PMantix/Switch_Charging_V2/pcb/specs/GDHUIZHT_B0512S_1WR3_product_photo.png

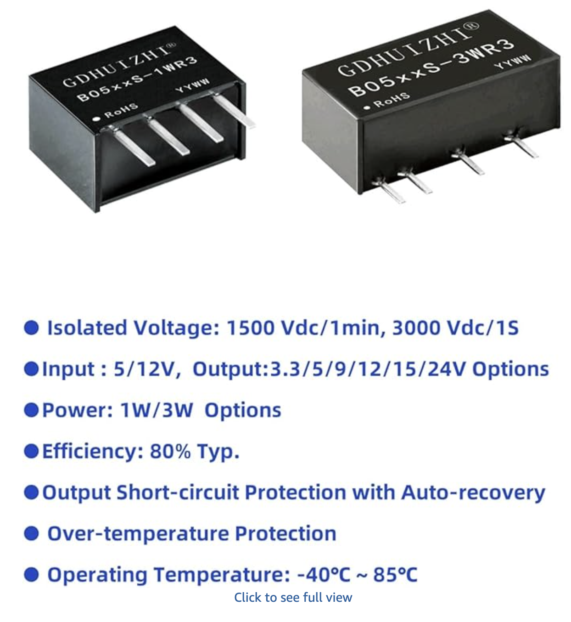
pcb/specs/GDHUIZHT_B0512S_1WR3_product_photo.png
