PMantix/Switch_Charging_V2/docs/Image.png

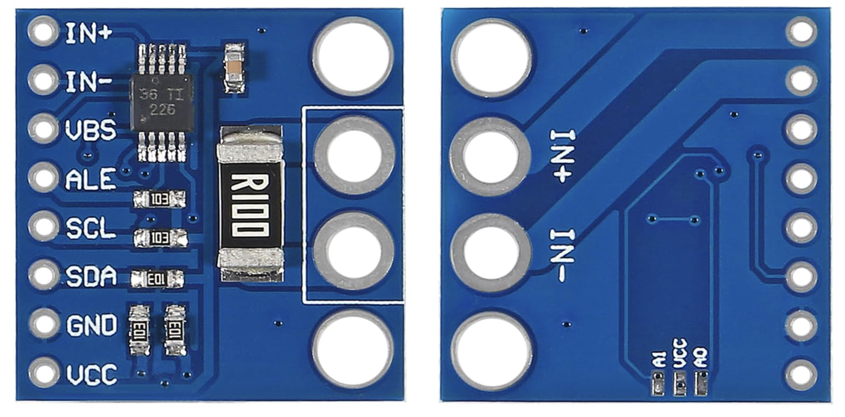
docs/Image.png
