PMantix/Switch_Charging_V2/pcb/specs/GDHUIZHT_B0512S_1WR3_pinout_dimensions.png

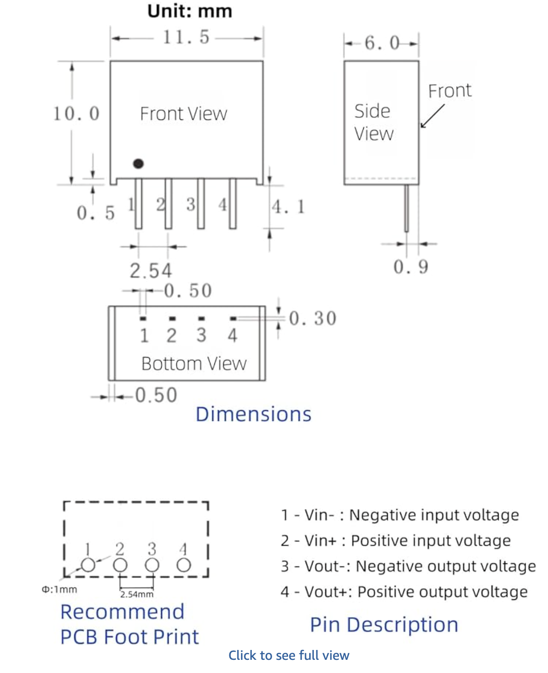
pcb/specs/GDHUIZHT_B0512S_1WR3_pinout_dimensions.png
