PMantix/Switch_Charging_V2/pcb/specs/GDHUIZHT_B0512S_1WR3_specs_general.png

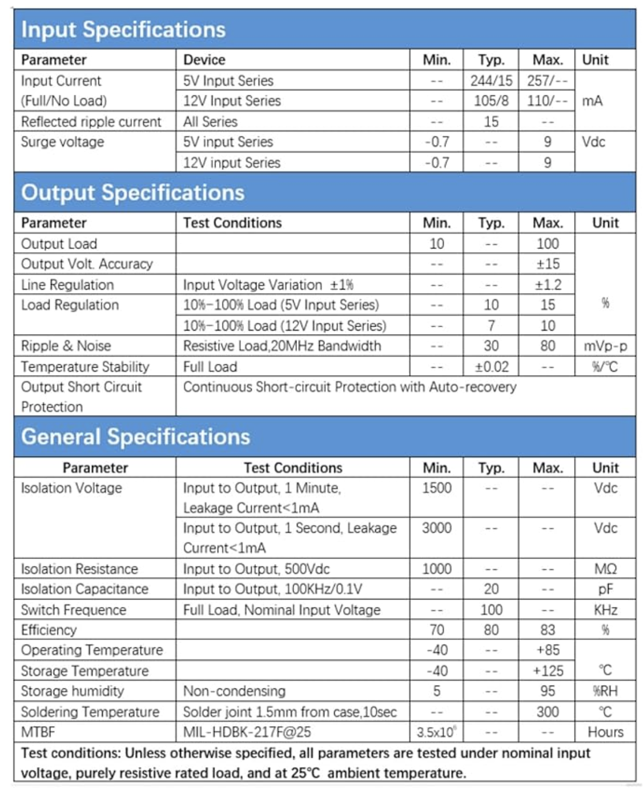
pcb/specs/GDHUIZHT_B0512S_1WR3_specs_general.png
