PMantix/Switch_Charging_V2/pcb/v2/switching_circuit_v2_preview.pdf

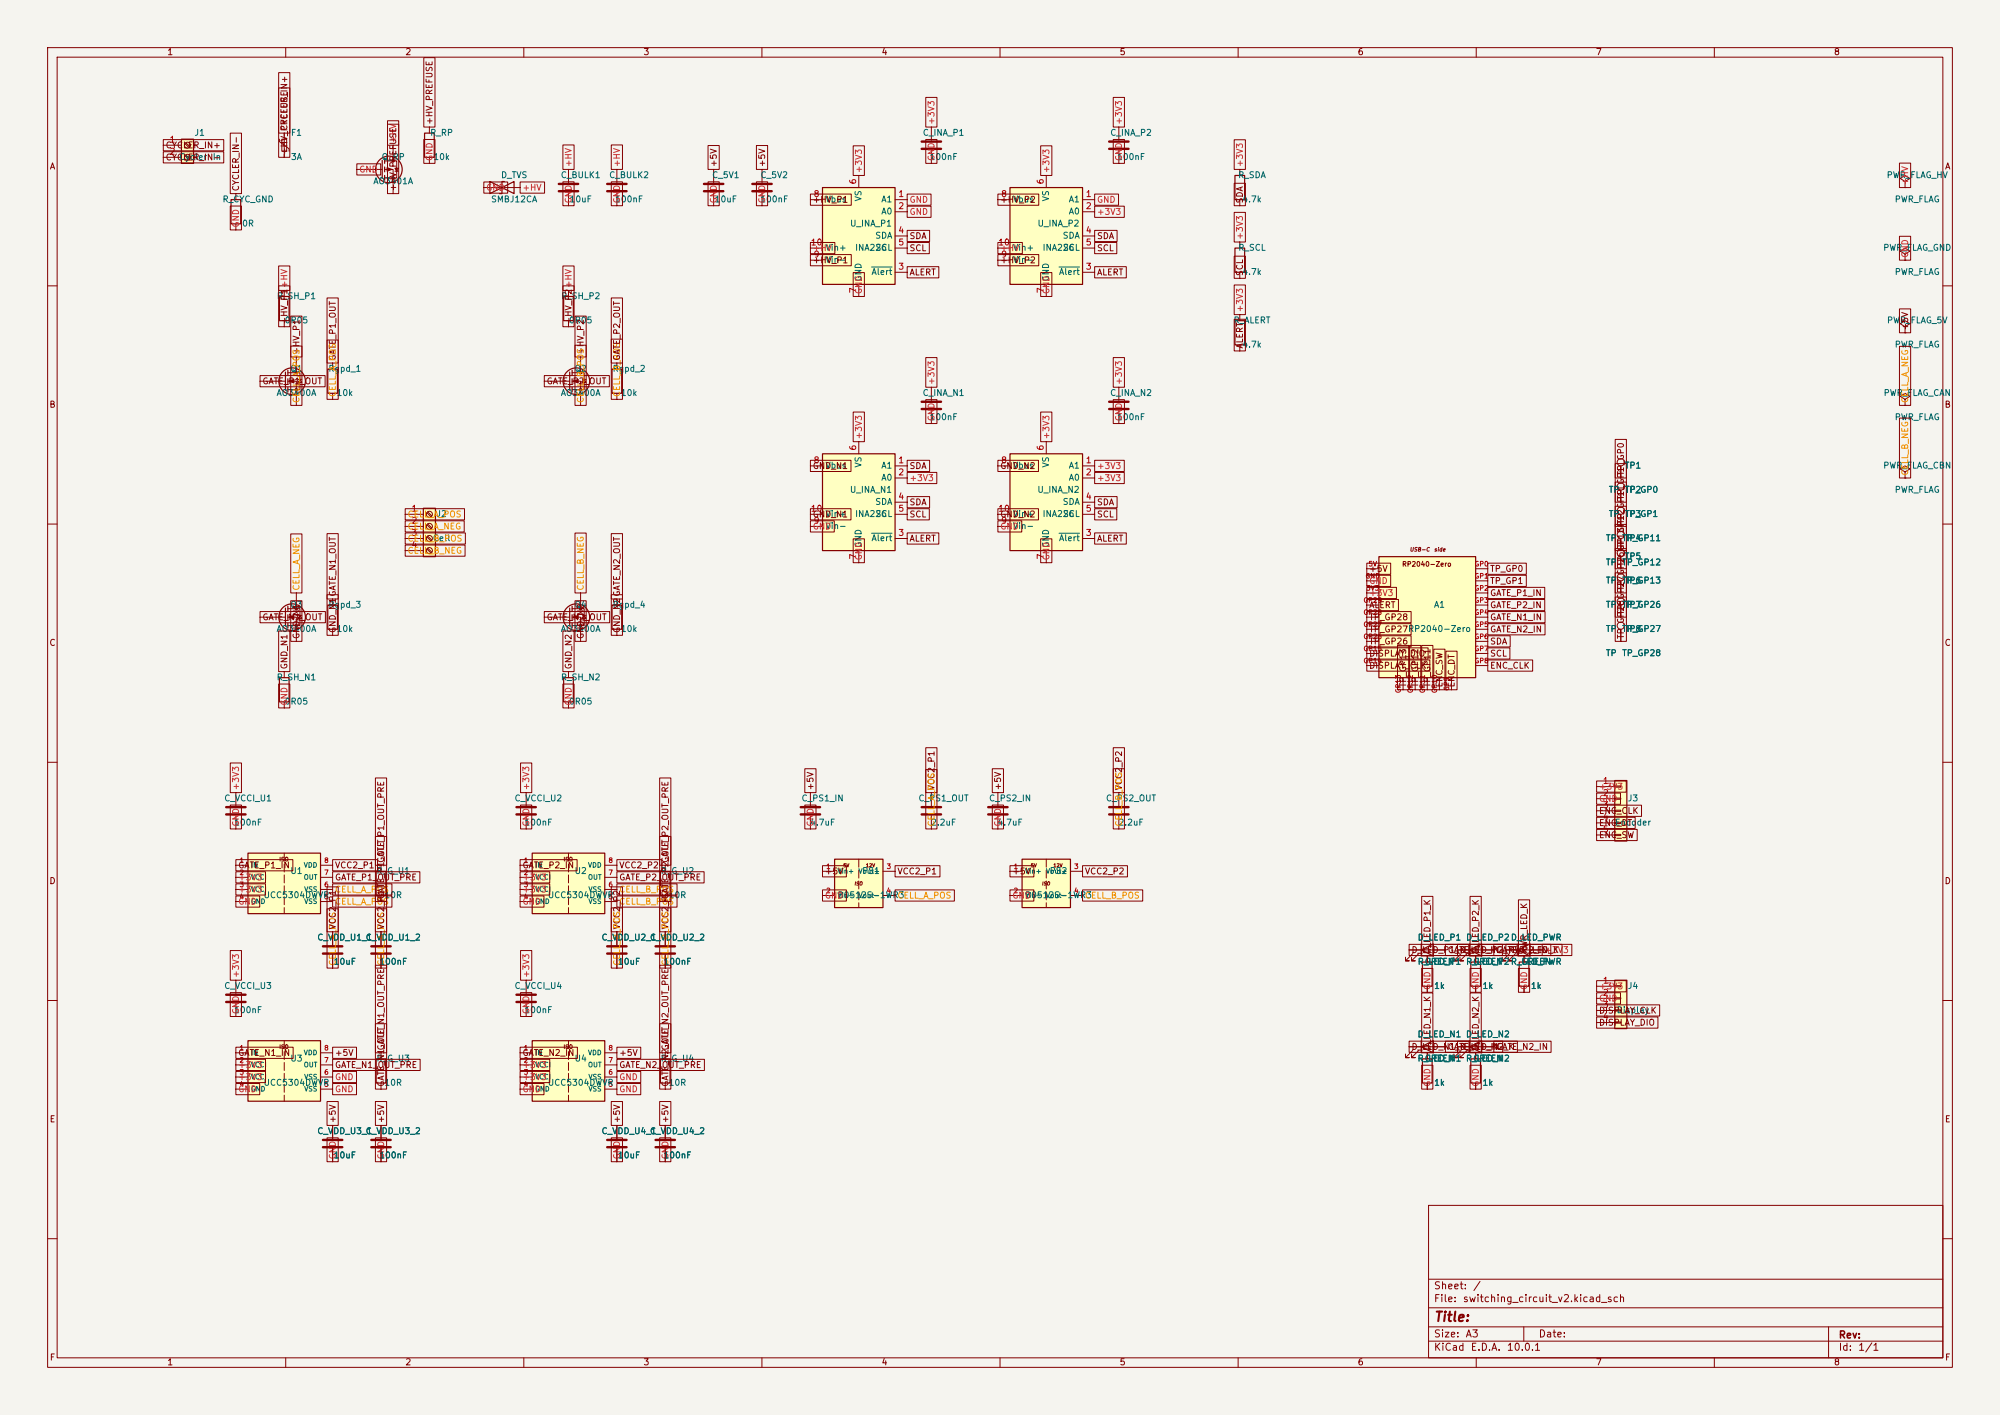
[picture p7: page 1]

Size: A3 | Rev:
KiCad E.D.A. 10.0.1 | Id: 1/1
