PMantix/Switch_Charging_V2/pcb/v3/switching_circuit_v3/switching_circuit_v3.kicad_pcb

## KiCad design pcb/v3/switching_circuit_v3/switching_circuit_v3.kicad_pcb (2026-05-26)

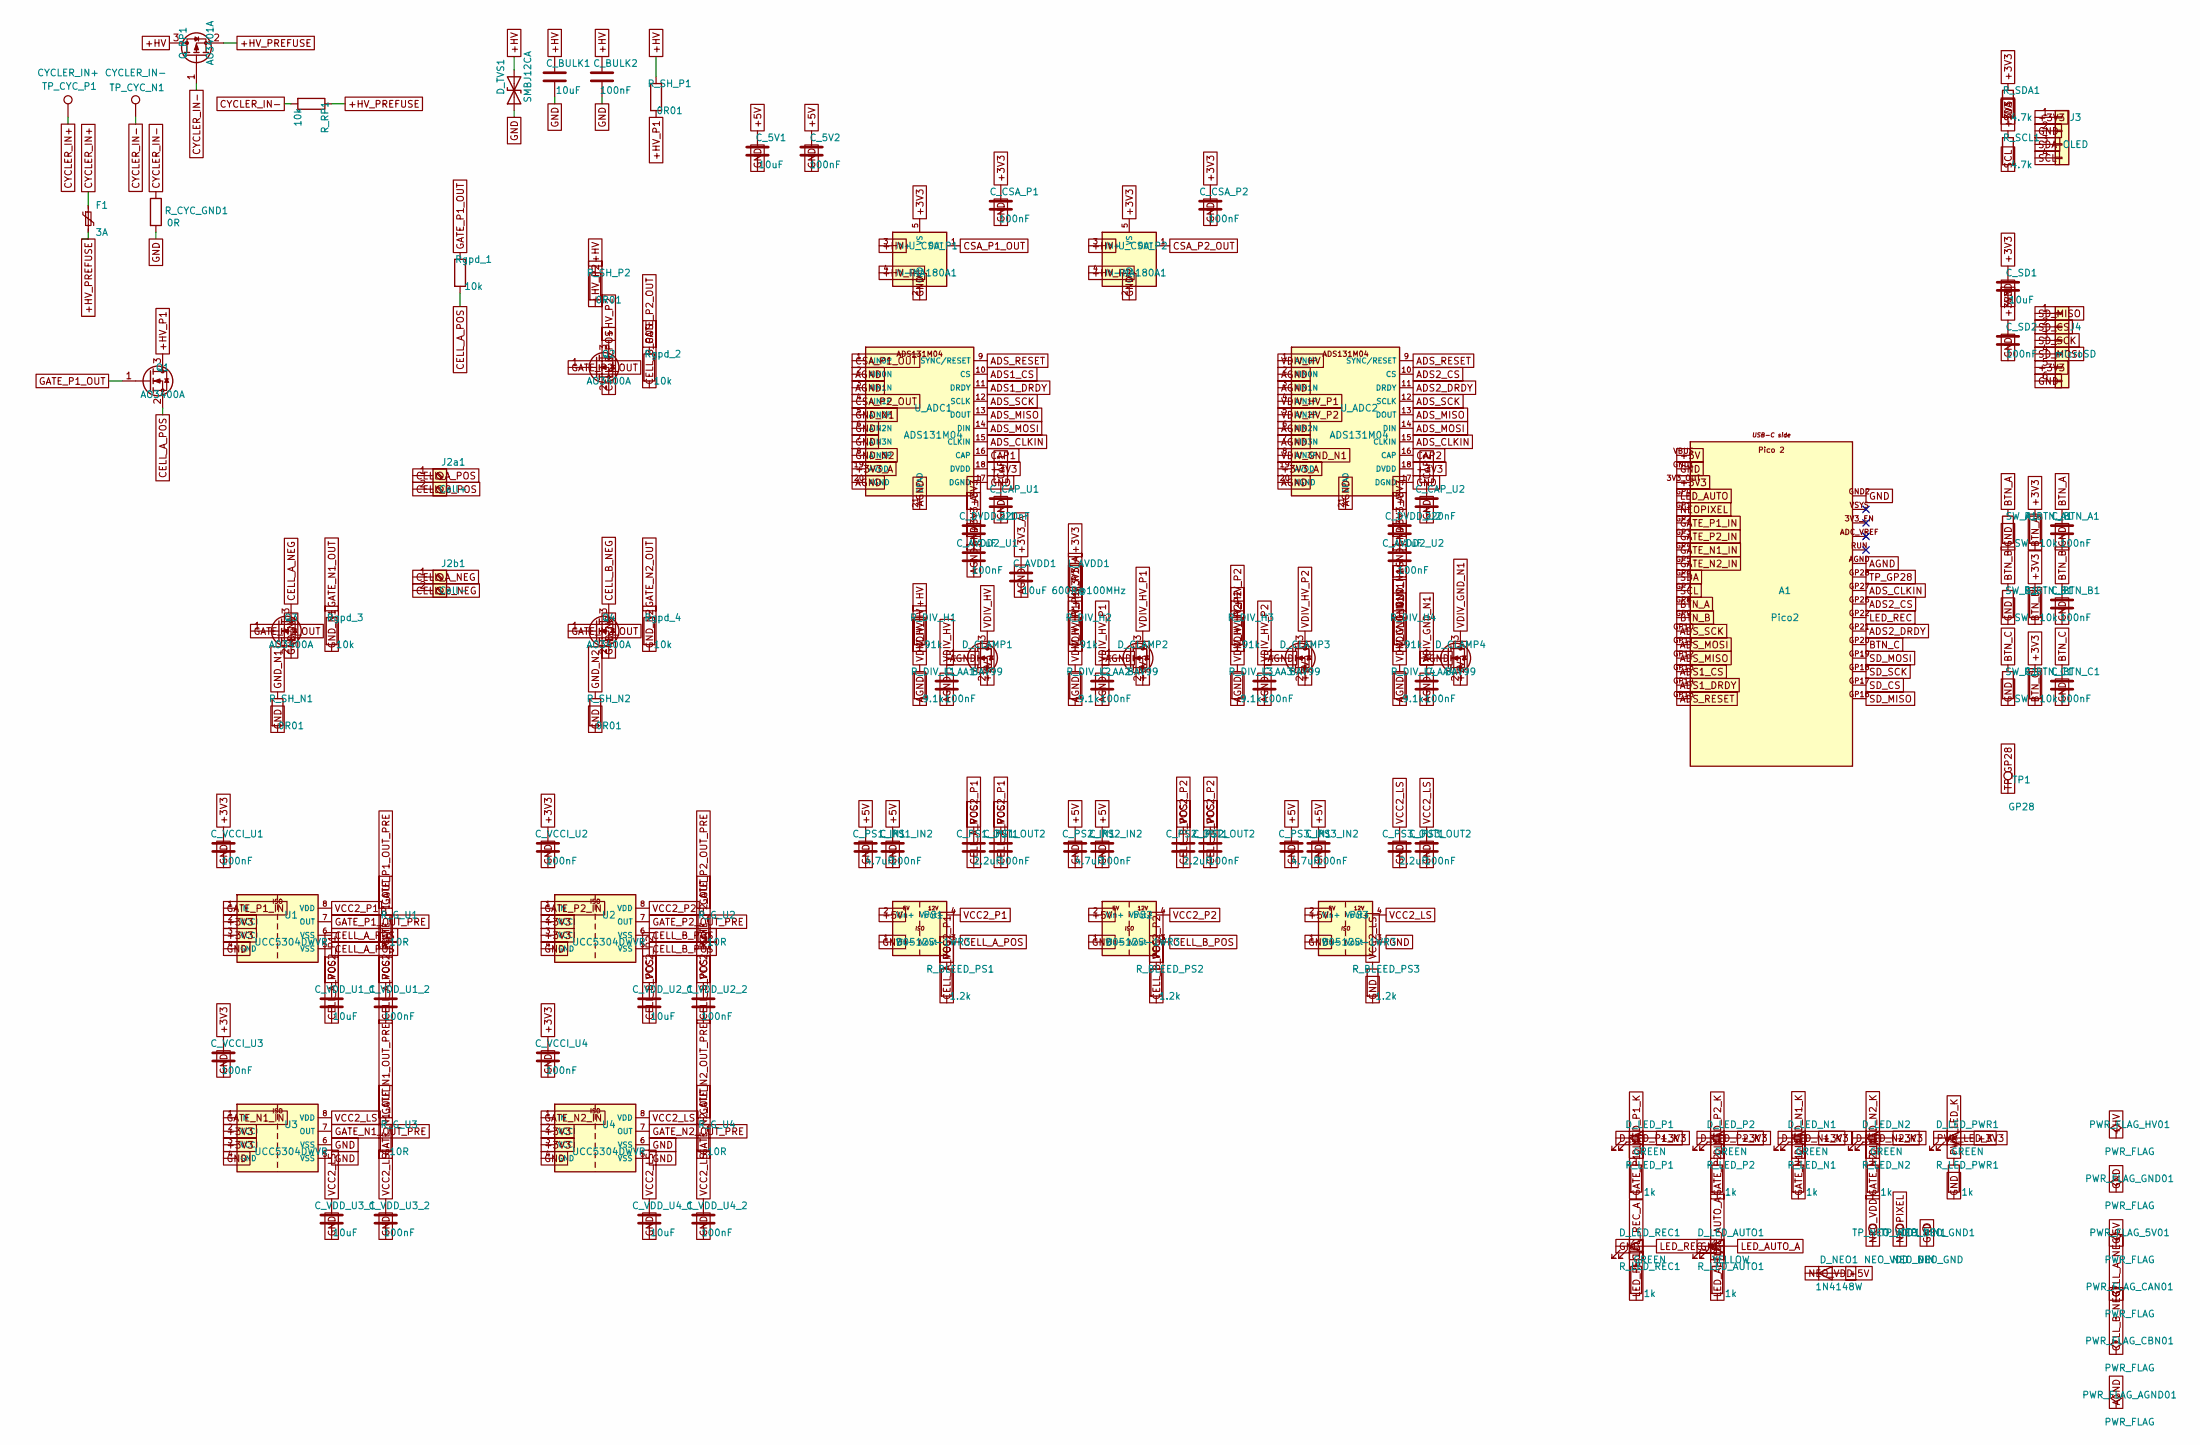
[picture p8: schematic switching_circuit_v3.kicad_sch]

Parts:
A1: Pico2; Pico2_SocketedTH
C_5V1: 10uF; C_0805_2012Metric
C_5V2: 100nF; C_0603_1608Metric
C_AA1, C_AA2, C_AA3, C_AA4: 100nF; C_0603_1608Metric
C_AVDD1: 10uF; C_0805_2012Metric
C_AVDD2_U1, C_AVDD2_U2: 100nF; C_0603_1608Metric
C_BTN_A1: 100nF; C_0603_1608Metric
C_BTN_B1: 100nF; C_0603_1608Metric
C_BTN_C1: 100nF; C_0603_1608Metric
C_BULK1: 10uF; C_1206_3216Metric
C_BULK2: 100nF; C_0603_1608Metric
C_CAP_U1, C_CAP_U2: 220nF; C_0603_1608Metric
C_CSA_P1, C_CSA_P2: 100nF; C_0603_1608Metric
C_DVDD_U1, C_DVDD_U2: 1uF; C_0603_1608Metric
C_PS1_IN1, C_PS2_IN1, C_PS3_IN1: 4.7uF; C_0805_2012Metric
C_PS1_IN2, C_PS1_OUT2, C_PS2_IN2, C_PS2_OUT2, C_PS3_IN2, C_PS3_OUT2: 100nF; C_0603_1608Metric
C_PS1_OUT1, C_PS2_OUT1, C_PS3_OUT1: 2.2uF; C_0805_2012Metric
C_SD1: 10uF; C_0805_2012Metric
C_SD2: 100nF; C_0603_1608Metric
C_VCCI_U1, C_VCCI_U2, C_VCCI_U3, C_VCCI_U4: 100nF; C_0603_1608Metric
C_VDD_U1_1, C_VDD_U2_1, C_VDD_U3_1, C_VDD_U4_1: 10uF; C_1206_3216Metric
C_VDD_U1_2, C_VDD_U2_2, C_VDD_U3_2, C_VDD_U4_2: 100nF; C_0603_1608Metric
D_CLAMP1, D_CLAMP2, D_CLAMP3, D_CLAMP4: BAV99; SOT-23
D_LED_AUTO1: YELLOW; LED_0603_1608Metric
D_LED_N1, D_LED_N2: GREEN; LED_0603_1608Metric
D_LED_P1, D_LED_P2: GREEN; LED_0603_1608Metric
D_LED_PWR1: GREEN; LED_0603_1608Metric
D_LED_REC1: GREEN; LED_0603_1608Metric
D_NEO1: 1N4148W; D_SOD-123
D_TVS1: SMBJ12CA; D_SMB; LCSC C87447
F1: 3A; Fuse_1812_4532Metric
J2a1: Cell+; TerminalBlock_Phoenix_MKDS-1,5-2-5.08_1x02_P5.08mm_Horizont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
J2b1: Cell-; TerminalBlock_Phoenix_MKDS-1,5-2-5.08_1x02_P5.08mm_Horizont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
J3: OLED; JST_XH_B4B-XH-A_1x04_P2.50mm_Vertical
J4: microSD; TF_PUSH
L_AVDD1: 600R@100MHz; R_0603_1608Metric
PS1, PS2, PS3: B0512S-1WR3; B0512S_1WR3_SIP4; MPN B0512S-1WR3
PWR_FLAG_5V01: PWR_FLAG
PWR_FLAG_AGND01: PWR_FLAG
PWR_FLAG_CAN01: PWR_FLAG
PWR_FLAG_CBN01: PWR_FLAG
PWR_FLAG_GND01: PWR_FLAG
PWR_FLAG_HV01: PWR_FLAG
Q1, Q2, Q3, Q4: AO3400A; SOT-23; MPN AO3400A; LCSC C20917
Q_RP1: AO3401A; SOT-23; MPN AO3401A; LCSC C15127
R_BLEED_PS1, R_BLEED_PS2, R_BLEED_PS3: 1.2k; R_0805_2012Metric
R_BTN_A1: 10k; R_0603_1608Metric
R_BTN_B1: 10k; R_0603_1608Metric
R_BTN_C1: 10k; R_0603_1608Metric
R_CYC_GND1: 0R; R_0805_2012Metric
R_DIV_H1, R_DIV_H2, R_DIV_H3, R_DIV_H4: 91k; R_0603_1608Metric
R_DIV_L1, R_DIV_L2, R_DIV_L3, R_DIV_L4: 9.1k; R_0603_1608Metric
R_G_U1, R_G_U2, R_G_U3, R_G_U4: 10R; R_0603_1608Metric
R_LED_AUTO1: 1k; R_0603_1608Metric
R_LED_N1, R_LED_N2: 1k; R_0603_1608Metric
R_LED_P1, R_LED_P2: 1k; R_0603_1608Metric
R_LED_PWR1: 1k; R_0603_1608Metric
R_LED_REC1: 1k; R_0603_1608Metric
R_RP1: 10k; R_0603_1608Metric
R_SCL1: 4.7k; R_0603_1608Metric
R_SDA1: 4.7k; R_0603_1608Metric
R_SH_N1, R_SH_N2: 0R01; R_2512_6332Metric
R_SH_P1, R_SH_P2: 0R01; R_2512_6332Metric
Rgpd_1, Rgpd_2, Rgpd_3, Rgpd_4: 10k; R_0603_1608Metric
SW_A1: SW; SW_SPST_TL3342
SW_B1: SW; SW_SPST_TL3342
SW_C1: SW; SW_SPST_TL3342
TP1: GP28; TestPoint_Pad_D1.5mm
TP_CYC_N1: CYCLER_IN-; TestPoint_Pad_D1.5mm
TP_CYC_P1: CYCLER_IN+; TestPoint_Pad_D1.5mm
TP_NEO_DIN1: NEO_DIN; TestPoint_Pad_D1.5mm
TP_NEO_GND1: NEO_GND; TestPoint_Pad_D1.5mm
TP_NEO_VDD1: NEO_VDD; TestPoint_Pad_D1.5mm
U1, U2, U3, U4: UCC5304DWVR; SOIC-8_DWV_7.5x11.5mm_P1.27mm; MPN UCC5304DWVR
U_ADC1, U_ADC2: ADS131M04; Texas_RUK0020B_WQFN-20-1EP_3x3mm_P0.4mm_EP1.7x1.7mm; LCSC C5121509
U_CSA_P1, U_CSA_P2: INA180A1; SOT-23-5; LCSC C122228

Connections:
+3V3: A1.3V3_OUT, C_CSA_P1.1, C_CSA_P2.1, C_DVDD_U1.1, C_DVDD_U2.1, C_SD1.1, C_SD2.1, C_VCCI_U1.1, C_VCCI_U2.1, C_VCCI_U3.1, C_VCCI_U4.1, D_LED_N1.2 (A), D_LED_N2.2 (A), D_LED_P1.2 (A), D_LED_P2.2 (A), D_LED_PWR1.2 (A), J3.1, J4.5, L_AVDD1.1, R_BTN_A1.1, R_BTN_B1.1, R_BTN_C1.1, R_SCL1.1, R_SDA1.1, U1.2 (VCCI), U1.3 (VCCI), U2.2 (VCCI), U2.3 (VCCI), U3.2 (VCCI), U3.3 (VCCI), U4.2 (VCCI), U4.3 (VCCI), U_ADC1.18 (DVDD), U_ADC2.18 (DVDD), U_CSA_P1.5 (VS), U_CSA_P2.5 (VS)
+3V3_A: C_AVDD1.1, C_AVDD2_U1.1, C_AVDD2_U2.1, D_CLAMP1.2 (S), D_CLAMP2.2 (S), D_CLAMP3.2 (S), D_CLAMP4.2 (S), L_AVDD1.2, U_ADC1.19 (AVDD), U_ADC2.19 (AVDD)
+5V: A1.VBUS, C_5V1.1, C_5V2.1, C_PS1_IN1.1, C_PS1_IN2.1, C_PS2_IN1.1, C_PS2_IN2.1, C_PS3_IN1.1, C_PS3_IN2.1, D_NEO1.2 (A), PS1.2 (Vin+), PS2.2 (Vin+), PS3.2 (Vin+), PWR_FLAG_5V01.1
+HV: C_BULK1.1, C_BULK2.1, D_TVS1.2 (A2), PWR_FLAG_HV01.1, Q_RP1.3 (D), R_DIV_H1.1, R_SH_P1.1, R_SH_P2.1, U_CSA_P1.3 (IN+), U_CSA_P2.3 (IN+)
+HV_P1: Q1.3 (D), R_DIV_H2.1, R_SH_P1.2, U_CSA_P1.4 (IN-)
+HV_P2: Q2.3 (D), R_DIV_H3.1, R_SH_P2.2, U_CSA_P2.4 (IN-)
+HV_PREFUSE: F1.2, Q_RP1.2 (S), R_RP1.1
ADS1_CS: A1.GP13, U_ADC1.10 (CS)
ADS1_DRDY: A1.GP14, U_ADC1.11 (DRDY)
ADS2_CS: A1.GP26, U_ADC2.10 (CS)
ADS2_DRDY: A1.GP21, U_ADC2.11 (DRDY)
ADS_CLKIN: A1.GP27, U_ADC1.15 (CLKIN), U_ADC2.15 (CLKIN)
ADS_MISO: A1.GP12, U_ADC1.13 (DOUT), U_ADC2.13 (DOUT)
ADS_MOSI: A1.GP11, U_ADC1.14 (DIN), U_ADC2.14 (DIN)
ADS_RESET: A1.GP15, U_ADC1.9 (SYNC/RESET), U_ADC2.9 (SYNC/RESET)
ADS_SCK: A1.GP10, U_ADC1.12 (SCLK), U_ADC2.12 (SCLK)
AGND: A1.AGND, C_AA1.2, C_AA2.2, C_AA3.2, C_AA4.2, C_AVDD1.2, C_AVDD2_U1.2, C_AVDD2_U2.2, D_CLAMP1.1 (G), D_CLAMP2.1 (G), D_CLAMP3.1 (G), D_CLAMP4.1 (G), PWR_FLAG_AGND01.1, R_DIV_L1.2, R_DIV_L2.2, R_DIV_L3.2, R_DIV_L4.2, U_ADC1.2 (AIN0N), U_ADC1.3 (AIN1N), U_ADC1.20 (AGND), U_ADC1.21 (EPAD), U_ADC2.2 (AIN0N), U_ADC2.3 (AIN1N), U_ADC2.6 (AIN2N), U_ADC2.7 (AIN3N), U_ADC2.20 (AGND), U_ADC2.21 (EPAD)
BTN_A: A1.GP8, C_BTN_A1.1, R_BTN_A1.2, SW_A1.1
BTN_B: A1.GP9, C_BTN_B1.1, R_BTN_B1.2, SW_B1.1
BTN_C: A1.GP20, C_BTN_C1.1, R_BTN_C1.2, SW_C1.1
CAP1: C_CAP_U1.1, U_ADC1.16 (CAP)
CAP2: C_CAP_U2.1, U_ADC2.16 (CAP)
CELL_A_NEG: J2b1.1, PWR_FLAG_CAN01.1, Q3.3 (D)
CELL_A_POS: C_PS1_OUT1.2, C_PS1_OUT2.2, C_VDD_U1_1.2, C_VDD_U1_2.2, J2a1.1, PS1.3 (Vout-), Q1.2 (S), R_BLEED_PS1.2, Rgpd_1.2, U1.5 (VSS), U1.6 (VSS)
CELL_B_NEG: J2b1.2, PWR_FLAG_CBN01.1, Q4.3 (D)
CELL_B_POS: C_PS2_OUT1.2, C_PS2_OUT2.2, C_VDD_U2_1.2, C_VDD_U2_2.2, J2a1.2, PS2.3 (Vout-), Q2.2 (S), R_BLEED_PS2.2, Rgpd_2.2, U2.5 (VSS), U2.6 (VSS)
CSA_P1_OUT: U_ADC1.1 (AIN0P), U_CSA_P1.1 (OUT)
CSA_P2_OUT: U_ADC1.4 (AIN1P), U_CSA_P2.1 (OUT)
CYCLER_IN+: F1.1, TP_CYC_P1.1 (1_1)
CYCLER_IN-: Q_RP1.1 (G), R_CYC_GND1.1, R_RP1.2, TP_CYC_N1.1 (1_1)
D_LED_N1_K: D_LED_N1.1 (K), R_LED_N1.1
D_LED_N2_K: D_LED_N2.1 (K), R_LED_N2.1
D_LED_P1_K: D_LED_P1.1 (K), R_LED_P1.1
D_LED_P2_K: D_LED_P2.1 (K), R_LED_P2.1
GATE_N1_IN: A1.GP4, R_LED_N1.2, U3.1 (IN)
GATE_N1_OUT: Q3.1 (G), R_G_U3.2, Rgpd_3.1
GATE_N1_OUT_PRE: R_G_U3.1, U3.7 (OUT)
GATE_N2_IN: A1.GP5, R_LED_N2.2, U4.1 (IN)
GATE_N2_OUT: Q4.1 (G), R_G_U4.2, Rgpd_4.1
GATE_N2_OUT_PRE: R_G_U4.1, U4.7 (OUT)
GATE_P1_IN: A1.GP2, R_LED_P1.2, U1.1 (IN)
GATE_P1_OUT: Q1.1 (G), R_G_U1.2, Rgpd_1.1
GATE_P1_OUT_PRE: R_G_U1.1, U1.7 (OUT)
GATE_P2_IN: A1.GP3, R_LED_P2.2, U2.1 (IN)
GATE_P2_OUT: Q2.1 (G), R_G_U2.2, Rgpd_2.1
GATE_P2_OUT_PRE: R_G_U2.1, U2.7 (OUT)
GND: A1.GND1 (GND), A1.GND2 (GND), C_5V1.2, C_5V2.2, C_BTN_A1.2, C_BTN_B1.2, C_BTN_C1.2, C_BULK1.2, C_BULK2.2, C_CAP_U1.2, C_CAP_U2.2, C_CSA_P1.2, C_CSA_P2.2, C_DVDD_U1.2, C_DVDD_U2.2, C_PS1_IN1.2, C_PS1_IN2.2, C_PS2_IN1.2, C_PS2_IN2.2, C_PS3_IN1.2, C_PS3_IN2.2, C_PS3_OUT1.2, C_PS3_OUT2.2, C_SD1.2, C_SD2.2, C_VCCI_U1.2, C_VCCI_U2.2, C_VCCI_U3.2, C_VCCI_U4.2, C_VDD_U3_1.2, C_VDD_U3_2.2, C_VDD_U4_1.2, C_VDD_U4_2.2, D_LED_AUTO1.1 (K), D_LED_REC1.1 (K), D_TVS1.1 (A1), J3.2, J4.6, PS1.1 (Vin-), PS2.1 (Vin-), PS3.1 (Vin-), PS3.3 (Vout-), PWR_FLAG_GND01.1, R_BLEED_PS3.2, R_CYC_GND1.2, R_LED_PWR1.2, R_SH_N1.2, R_SH_N2.2, SW_A1.2, SW_B1.2, SW_C1.2, TP_NEO_GND1.1 (1_1), U1.4 (GND), U2.4 (GND), U3.4 (GND), U3.5 (VSS), U3.6 (VSS), U4.4 (GND), U4.5 (VSS), U4.6 (VSS), U_ADC1.6 (AIN2N), U_ADC1.7 (AIN3N), U_ADC1.17 (DGND), U_ADC2.17 (DGND), U_CSA_P1.2 (GND), U_CSA_P2.2 (GND)
GND_N1: Q3.2 (S), R_DIV_H4.1, R_SH_N1.1, Rgpd_3.2, U_ADC1.5 (AIN2P)
GND_N2: Q4.2 (S), R_SH_N2.1, Rgpd_4.2, U_ADC1.8 (AIN3P)
LED_AUTO: A1.GP0, R_LED_AUTO1.2
LED_AUTO_A: D_LED_AUTO1.2 (A), R_LED_AUTO1.1
LED_REC: A1.GP22, R_LED_REC1.2
LED_REC_A: D_LED_REC1.2 (A), R_LED_REC1.1
NEOPIXEL: A1.GP1, TP_NEO_DIN1.1 (1_1)
NEO_VDD: D_NEO1.1 (K), TP_NEO_VDD1.1 (1_1)
PWR_LED_K: D_LED_PWR1.1 (K), R_LED_PWR1.1
SCL: A1.GP7, J3.4, R_SCL1.2
SDA: A1.GP6, J3.3, R_SDA1.2
SD_CS: A1.GP17, J4.2
SD_MISO: A1.GP16, J4.1
SD_MOSI: A1.GP19, J4.4
SD_SCK: A1.GP18, J4.3
TP_GP28: A1.GP28, TP1.1 (1_1)
VCC2_LS: C_PS3_OUT1.1, C_PS3_OUT2.1, C_VDD_U3_1.1, C_VDD_U3_2.1, C_VDD_U4_1.1, C_VDD_U4_2.1, PS3.4 (Vout+), R_BLEED_PS3.1, U3.8 (VDD), U4.8 (VDD)
VCC2_P1: C_PS1_OUT1.1, C_PS1_OUT2.1, C_VDD_U1_1.1, C_VDD_U1_2.1, PS1.4 (Vout+), R_BLEED_PS1.1, U1.8 (VDD)
VCC2_P2: C_PS2_OUT1.1, C_PS2_OUT2.1, C_VDD_U2_1.1, C_VDD_U2_2.1, PS2.4 (Vout+), R_BLEED_PS2.1, U2.8 (VDD)
VDIV_GND_N1: C_AA4.1, D_CLAMP4.3 (D), R_DIV_H4.2, R_DIV_L4.1, U_ADC2.8 (AIN3P)
VDIV_HV: C_AA1.1, D_CLAMP1.3 (D), R_DIV_H1.2, R_DIV_L1.1, U_ADC2.1 (AIN0P)
VDIV_HV_P1: C_AA2.1, D_CLAMP2.3 (D), R_DIV_H2.2, R_DIV_L2.1, U_ADC2.4 (AIN1P)
VDIV_HV_P2: C_AA3.1, D_CLAMP3.3 (D), R_DIV_H3.2, R_DIV_L3.1, U_ADC2.5 (AIN2P)

Board: 2 copper layers, 128 parts (0 on the bottom side), 70 nets, no tracks yet.
