PMantix/Switch_Charging_V2/pcb/v2/switching_circuit_v2/switching_circuit_v2.kicad_pcb

## KiCad design pcb/v2/switching_circuit_v2/switching_circuit_v2.kicad_pcb (2026-04-21, an earlier design)

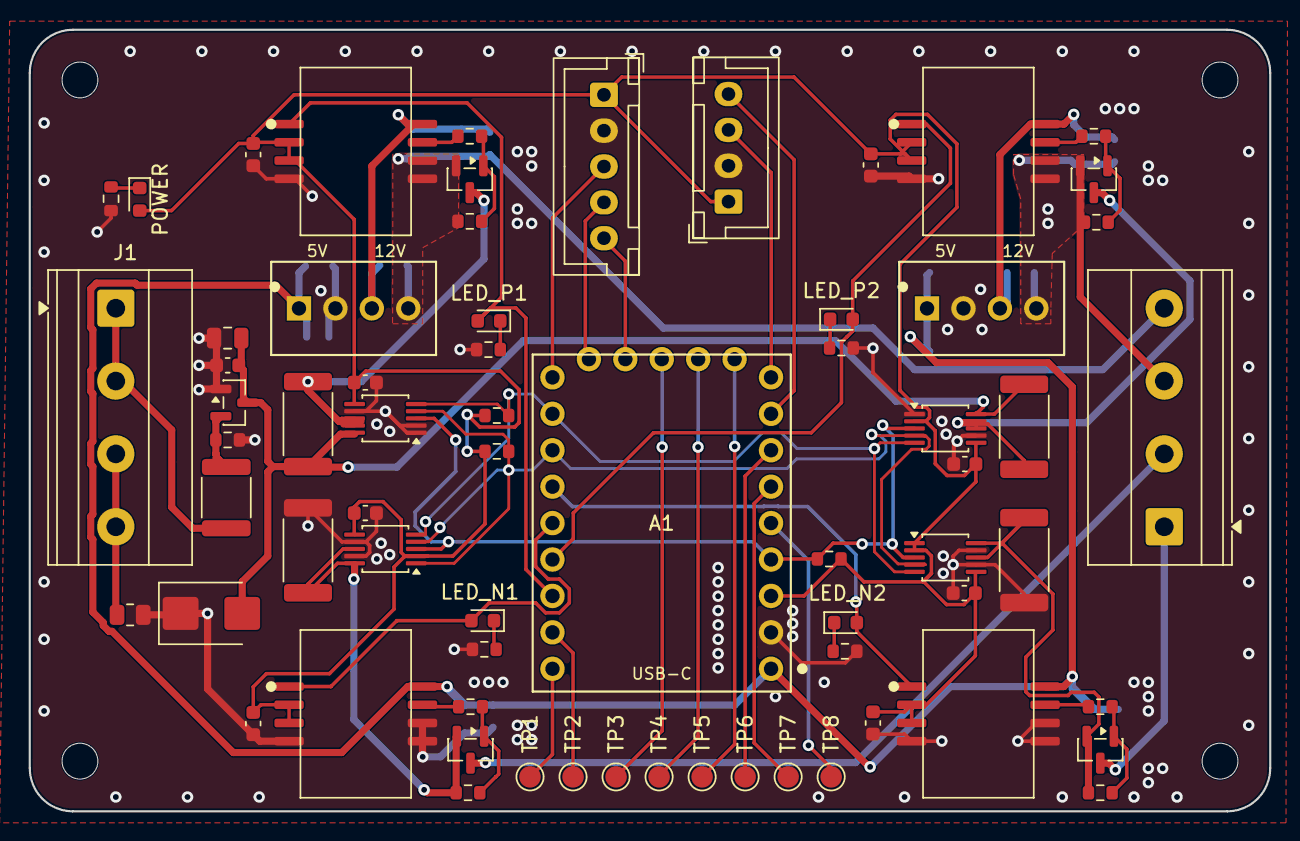
[picture p9: board switching_circuit_v2.kicad_pcb from above]

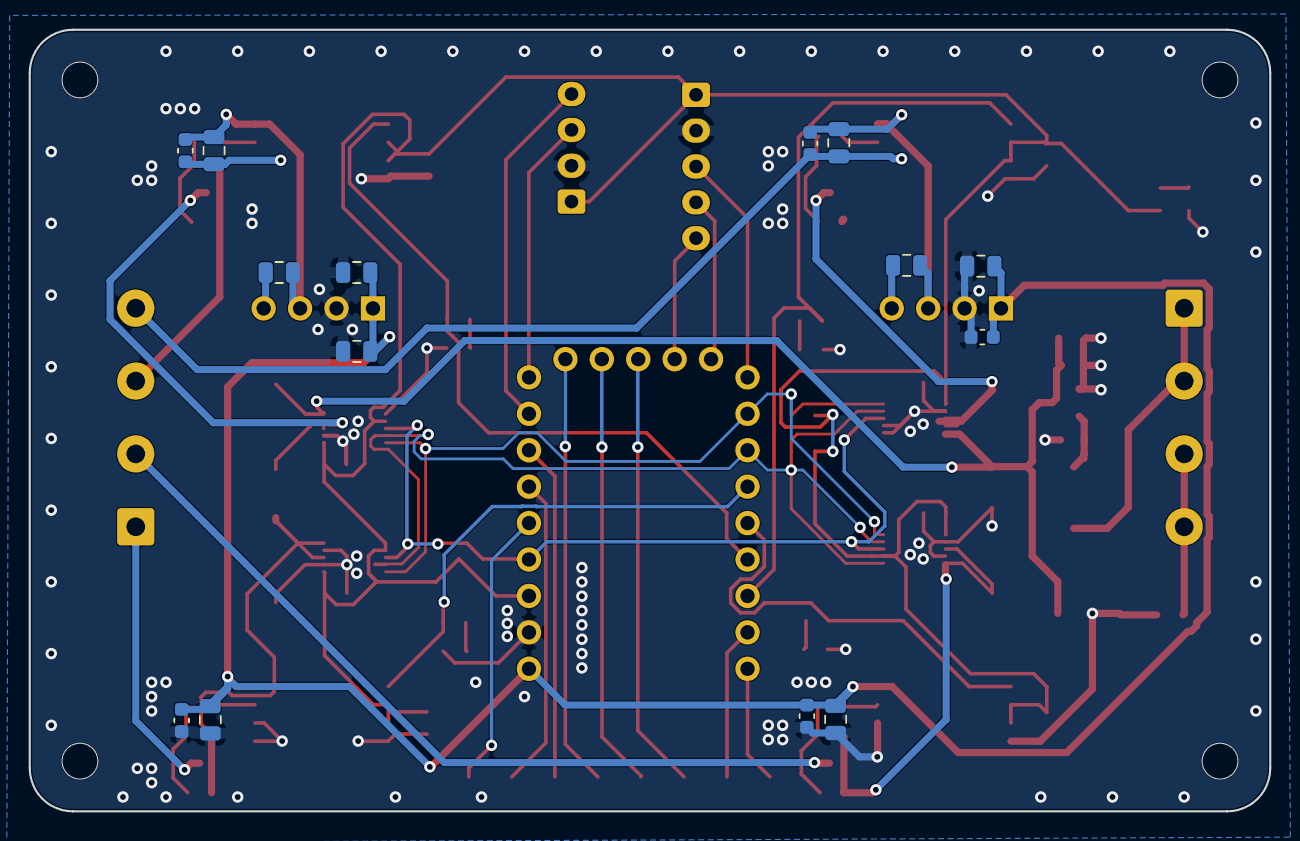
[picture p10: board switching_circuit_v2.kicad_pcb from below]

Board: 2 copper layers, 86.5 x 54.5 mm, 81 parts (14 on the bottom side), 50 nets.

Parts:
A1: RP2040-Zero; RP2040_Zero_SocketedTH
C_5V1: 10uF; C_0805_2012Metric
C_5V2: 100nF; C_0603_1608Metric
C_B1: 10uF; C_0805_2012Metric
C_B2: 100nF; C_0603_1608Metric
C_INA_N1, C_INA_N2: 100nF; C_0603_1608Metric
C_INA_P1, C_INA_P2: 100nF; C_0603_1608Metric
C_PS1_IN1, C_PS2_IN1: 4.7uF; C_0805_2012Metric
C_PS1_OUT1, C_PS2_OUT1: 2.2uF; C_0805_2012Metric
C_VCCI_U1, C_VCCI_U2, C_VCCI_U3, C_VCCI_U4: 100nF; C_0603_1608Metric
C_VDD_U1_1, C_VDD_U2_1, C_VDD_U3_1, C_VDD_U4_1: 10uF; C_0805_2012Metric
C_VDD_U1_2, C_VDD_U2_2, C_VDD_U3_2, C_VDD_U4_2: 100nF; C_0603_1608Metric
D_LED_N1: GREEN; LED_0603_1608Metric
D_TVS1: SMBJ12CA; D_SMB
F1: 3A; Fuse_1812_4532Metric
J1: Cycler In; TerminalBlock_Phoenix_MKDS-1,5-4-5.08_1x04_P5.08mm_Horizont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
J2: Cell; TerminalBlock_Phoenix_MKDS-1,5-4-5.08_1x04_P5.08mm_Horizont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
J3: Encoder; JST_XH_B5B-XH-A_1x05_P2.50mm_Vertical
J4: Display; JST_XH_B4B-XH-A_1x04_P2.50mm_Vertical
LED_N1: 1k; R_0603_1608Metric
LED_N2: GREEN; LED_0603_1608Metric
LED_P1, LED_P2: GREEN; LED_0603_1608Metric
POWER: GREEN; LED_0603_1608Metric
PS1, PS2: B0512S-1WR3; B0512S_1WR3_SIP4
Q1, Q2, Q3, Q4: AO3400A; SOT-23
Q_RP1: AO3401A; SOT-23
R_ALERT1: 4.7k; R_0603_1608Metric
R_CYC_GND1: 0R; R_0805_2012Metric
R_G_U1, R_G_U2, R_G_U3, R_G_U4: 10R; R_0603_1608Metric
R_LED_N2: 1k; R_0603_1608Metric
R_LED_P1, R_LED_P2: 1k; R_0603_1608Metric
R_LED_PWR1: 1k; R_0603_1608Metric
R_RP1: 10k; R_0603_1608Metric
R_SCL1: 4.7k; R_0603_1608Metric
R_SDA1: 4.7k; R_0603_1608Metric
R_SH_N1, R_SH_N2: 0R05; R_2512_6332Metric
R_SH_P1, R_SH_P2: 0R05; R_2512_6332Metric
Rgpd_1, Rgpd_2, Rgpd_3, Rgpd_4: 10k; R_0603_1608Metric
TP1: TP TP_GP0; TestPoint_Pad_D1.5mm
TP2: TP TP_GP1; TestPoint_Pad_D1.5mm
TP3: TP TP_GP11; TestPoint_Pad_D1.5mm
TP4: TP TP_GP12; TestPoint_Pad_D1.5mm
TP5: TP TP_GP13; TestPoint_Pad_D1.5mm
TP6: TP TP_GP26; TestPoint_Pad_D1.5mm
TP7: TP TP_GP27; TestPoint_Pad_D1.5mm
TP8: TP TP_GP28; TestPoint_Pad_D1.5mm
U1, U2, U3, U4: UCC5304DWVR; SOIC-8_DWV_7.5x11.5mm_P1.27mm
U_INA_N1, U_INA_N2: INA226; TSSOP-10_3x3mm_P0.5mm
U_INA_P1, U_INA_P2: INA226; TSSOP-10_3x3mm_P0.5mm

Connections:
+3V3: A1.3V3, C_INA_N1.1, C_INA_N2.1, C_INA_P1.1, C_INA_P2.1, C_VCCI_U1.1, C_VCCI_U2.1, C_VCCI_U3.1, C_VCCI_U4.1, J3.1, J4.1, POWER.2 (A), R_ALERT1.1, R_SCL1.1, R_SDA1.1, U1.2 (VCCI), U1.3 (VCCI), U2.2 (VCCI), U2.3 (VCCI), U3.2 (VCCI), U3.3 (VCCI), U4.2 (VCCI), U4.3 (VCCI), U_INA_N1.2 (A0), U_INA_N1.6 (VS), U_INA_N2.1 (A1), U_INA_N2.2 (A0), U_INA_N2.6 (VS), U_INA_P1.6 (VS), U_INA_P2.2 (A0), U_INA_P2.6 (VS)
+5V: A1.5V, C_5V1.1, C_5V2.1, C_PS1_IN1.1, C_PS2_IN1.1, C_VDD_U3_1.1, C_VDD_U3_2.1, C_VDD_U4_1.1, C_VDD_U4_2.1, PS1.1 (Vin+), PS2.1 (Vin+), U3.8 (VDD), U4.8 (VDD)
+HV: C_B1.1, C_B2.1, D_TVS1.2 (A2), Q_RP1.3 (D), R_SH_P1.1, R_SH_P2.1, U_INA_P1.10 (Vin+), U_INA_P2.10 (Vin+)
+HV_P1: Q1.3 (D), R_SH_P1.2, U_INA_P1.8 (Vbus), U_INA_P1.9 (Vin-)
+HV_P2: Q2.3 (D), R_SH_P2.2, U_INA_P2.8 (Vbus), U_INA_P2.9 (Vin-)
+HV_PREFUSE: F1.2, Q_RP1.2 (S), R_RP1.1
ALERT: A1.GP29, R_ALERT1.2, U_INA_N1.3 (~Alert), U_INA_N2.3 (~Alert), U_INA_P1.3 (~Alert), U_INA_P2.3 (~Alert)
CELL_A_NEG: J2.2, Q3.3 (D)
CELL_A_POS: C_PS1_OUT1.2, C_VDD_U1_1.2, C_VDD_U1_2.2, J2.4, PS1.4 (Vout-), Q1.2 (S), Rgpd_1.2, U1.5 (VSS), U1.6 (VSS)
CELL_B_NEG: J2.1, Q4.3 (D)
CELL_B_POS: C_PS2_OUT1.2, C_VDD_U2_1.2, C_VDD_U2_2.2, J2.3, PS2.4 (Vout-), Q2.2 (S), Rgpd_2.2, U2.5 (VSS), U2.6 (VSS)
CYCLER_IN+: F1.1, J1.1, J1.2
CYCLER_IN-: J1.3, J1.4, R_CYC_GND1.1
DISPLAY_CLK: A1.GP14, J4.3
DISPLAY_DIO: A1.GP15, J4.4
D_LED_N1_K: D_LED_N1.1 (K), LED_N1.1
D_LED_N2_K: LED_N2.1 (K), R_LED_N2.1
D_LED_P1_K: LED_P1.1 (K), R_LED_P1.1
D_LED_P2_K: LED_P2.1 (K), R_LED_P2.1
ENC_CLK: A1.GP8, J3.3
ENC_DT: A1.GP9, J3.4
ENC_SW: A1.GP10, J3.5
GATE_N1_IN: A1.GP4, D_LED_N1.2 (A), U3.1 (IN)
GATE_N1_OUT: Q3.1 (G), R_G_U3.2, Rgpd_3.1
GATE_N1_OUT_PRE: R_G_U3.1, U3.7 (OUT)
GATE_N2_IN: A1.GP5, LED_N2.2 (A), U4.1 (IN)
GATE_N2_OUT: Q4.1 (G), R_G_U4.2, Rgpd_4.1
GATE_N2_OUT_PRE: R_G_U4.1, U4.7 (OUT)
GATE_P1_IN: A1.GP2, LED_P1.2 (A), U1.1 (IN)
GATE_P1_OUT: Q1.1 (G), R_G_U1.2, Rgpd_1.1
GATE_P1_OUT_PRE: R_G_U1.1, U1.7 (OUT)
GATE_P2_IN: A1.GP3, LED_P2.2 (A), U2.1 (IN)
GATE_P2_OUT: Q2.1 (G), R_G_U2.2, Rgpd_2.1
GATE_P2_OUT_PRE: R_G_U2.1, U2.7 (OUT)
GND: A1.GND, C_5V1.2, C_5V2.2, C_B1.2, C_B2.2, C_INA_N1.2, C_INA_N2.2, C_INA_P1.2, C_INA_P2.2, C_PS1_IN1.2, C_PS2_IN1.2, C_VCCI_U1.2, C_VCCI_U2.2, C_VCCI_U3.2, C_VCCI_U4.2, C_VDD_U3_1.2, C_VDD_U3_2.2, C_VDD_U4_1.2, C_VDD_U4_2.2, D_TVS1.1 (A1), J3.2, J4.2, LED_N1.2, PS1.2 (Vin-), PS2.2 (Vin-), Q_RP1.1 (G), R_CYC_GND1.2, R_LED_N2.2, R_LED_P1.2, R_LED_P2.2, R_LED_PWR1.2, R_RP1.2, R_SH_N1.2, R_SH_N2.2, U1.4 (GND), U2.4 (GND), U3.4 (GND), U3.5 (VSS), U3.6 (VSS), U4.4 (GND), U4.5 (VSS), U4.6 (VSS), U_INA_N1.7 (GND), U_INA_N1.9 (Vin-), U_INA_N2.7 (GND), U_INA_N2.9 (Vin-), U_INA_P1.1 (A1), U_INA_P1.2 (A0), U_INA_P1.7 (GND), U_INA_P2.1 (A1), U_INA_P2.7 (GND)
GND_N1: Q3.2 (S), R_SH_N1.1, Rgpd_3.2, U_INA_N1.8 (Vbus), U_INA_N1.10 (Vin+)
GND_N2: Q4.2 (S), R_SH_N2.1, Rgpd_4.2, U_INA_N2.8 (Vbus), U_INA_N2.10 (Vin+)
PWR_LED_K: POWER.1 (K), R_LED_PWR1.1
SCL: A1.GP7, R_SCL1.2, U_INA_N1.5 (SCL), U_INA_N2.5 (SCL), U_INA_P1.5 (SCL), U_INA_P2.5 (SCL)
SDA: A1.GP6, R_SDA1.2, U_INA_N1.1 (A1), U_INA_N1.4 (SDA), U_INA_N2.4 (SDA), U_INA_P1.4 (SDA), U_INA_P2.4 (SDA)
TP_GP0: A1.GP0, TP1.1 (1_1)
TP_GP1: A1.GP1, TP2.1 (1_1)
TP_GP11: A1.GP11, TP3.1 (1_1)
TP_GP12: A1.GP12, TP4.1 (1_1)
TP_GP13: A1.GP13, TP5.1 (1_1)
TP_GP26: A1.GP26, TP6.1 (1_1)
TP_GP27: A1.GP27, TP7.1 (1_1)
TP_GP28: A1.GP28, TP8.1 (1_1)
VCC2_P1: C_PS1_OUT1.1, C_VDD_U1_1.1, C_VDD_U1_2.1, PS1.3 (Vout+), U1.8 (VDD)
VCC2_P2: C_PS2_OUT1.1, C_VDD_U2_1.1, C_VDD_U2_2.1, PS2.3 (Vout+), U2.8 (VDD)
