PMantix/Switch_Charging_V2/server/sequence_engine.py

"""
Switching Circuit V2 - Sequence Engine (thin wrapper over RP2040 timer).

The RP2040 firmware now owns periodic switching via machine.Timer
(see firmware/main.py). This module's job is to translate high-level
Pi-side requests — set_frequency, set_sequence, set_pulse_mode,
pause/resume — into the firmware's C/F/G/H command set, and to
present an estimated "current step" for status reporting by computing
it from elapsed time since the last resume or frequency change.

The estimate drifts slightly from the RP2040's true _seq_idx because
the Pi and RP2040 clocks are not synchronized, but the drift stays
well under one step for display purposes and there's no way to get
the firmware's index without a round-trip per query.
"""

import logging
import threading
from time import monotonic
from typing import Optional

from server.config import (
    SEQUENCES, STATE_DEFS, NUM_SEQUENCES,
    DEFAULT_FREQ, MIN_FREQ, MAX_FREQ,
    PULSE_CHARGE_SEQUENCE,
)

log = logging.getLogger(__name__)

# Debounce window: when set_frequency/set_sequence/set_pulse_mode are called
# in rapid succession (e.g. a held `w` key on the TUI), we coalesce the
# outbound serial commands to the RP2040 instead of firing one per call.
# Internal state updates still happen immediately so the status broadcast
# and TUI display reflect the new value right away; only the RP2040 wait
# gets deferred. 150 ms is short enough to feel instant but long enough to
# swallow typical key-repeat bursts (~30/sec).
_DEBOUNCE_S = 0.15


def _pack_state(state_tuple):
    """Pack a (P1, P2, N1, N2) tuple of bools/ints into a 4-bit int."""
    return (
        (int(bool(state_tuple[0])) << 3)
        | (int(bool(state_tuple[1])) << 2)
        | (int(bool(state_tuple[2])) << 1)
        | int(bool(state_tuple[3]))
    )


class SequenceEngine:
    """Programs the RP2040's firmware-resident switching cycle and tracks
    a running estimate of the current step for status reporting."""

    def __init__(self, gpio_driver):
        self._gpio = gpio_driver
        self._lock = threading.Lock()

        self._sequence_index = 0        # 0-based into SEQUENCES
        self._frequency = DEFAULT_FREQ
        self._pulse_mode = False
        self._paused = True             # start paused; mode controller resumes

        # Running-state tracking (in Pi's monotonic clock). When we program
        # the firmware, we note (step_at_resume, resume_time, period_us)
        # so get_state() can estimate the current step by:
        #     step = (step_at_resume + (now - resume_time) / period) % n
        self._step_at_resume = 0
        self._resume_time = 0.0
        self._period_us = 0

        # Debounce state — see _DEBOUNCE_S comment above.
        self._flush_timer: Optional[threading.Timer] = None
        self._pending_period = False    # F command waiting to send
        self._pending_cycle = False     # C+F+G reprogram waiting to send

        log.info("SequenceEngine (RP2040-driven) initialised: freq=%.1f Hz, seq=%d",
                 self._frequency, self._sequence_index)

    # -- public API (thread-safe) -------------------------------------------

    def set_frequency(self, hz):
        """Set switching frequency, clamped to [MIN_FREQ, MAX_FREQ].

        Internal state updates immediately; the actual F command to the
        RP2040 is debounced so a held key doesn't saturate the serial link."""
        hz = max(MIN_FREQ, min(MAX_FREQ, float(hz)))
        with self._lock:
            if not self._paused and self._period_us > 0:
                # Snapshot the current step before the period changes so
                # elapsed-time estimation remains monotonic.
                self._step_at_resume = self._estimate_step_locked()
                self._resume_time = monotonic()
            self._frequency = hz
            self._period_us = self._compute_period_us_locked()
            if not self._paused:
                self._pending_period = True
                self._schedule_flush_locked()
        log.info("Frequency set to %.2f Hz", hz)

    def get_frequency(self):
        with self._lock:
            return self._frequency

    def set_sequence(self, index):
        index = max(0, min(NUM_SEQUENCES - 1, int(index)))
        with self._lock:
            self._sequence_index = index
            self._step_at_resume = 0
            self._resume_time = monotonic()
            if not self._paused:
                self._pending_cycle = True
                self._schedule_flush_locked()
        log.info("Sequence set to %d (%s)", index, SEQUENCES[index])

    def get_sequence(self):
        with self._lock:
            return self._sequence_index

    def set_pulse_mode(self, enabled):
        """Toggle pulse charge mode — uses the fixed 2-step PULSE_CHARGE_SEQUENCE
        with doubled step period so the overall cycle time matches."""
        with self._lock:
            self._pulse_mode = bool(enabled)
            self._step_at_resume = 0
            self._resume_time = monotonic()
            self._period_us = self._compute_period_us_locked()
            if not self._paused:
                self._pending_cycle = True
                self._schedule_flush_locked()
        log.info("Pulse mode %s", "enabled" if enabled else "disabled")

    def pause(self):
        """Halt switching on the RP2040 and leave all FETs off."""
        was_running = False
        with self._lock:
            was_running = not self._paused
            self._paused = True
            self._cancel_flush_locked()
        if was_running:
            self._gpio.stop_switching()
        log.debug("SequenceEngine paused")

    def pause_silent(self):
        """Mark engine as paused without sending H (all-off) to the RP2040.
        Used for seamless transitions where FETs must stay conducting."""
        with self._lock:
            self._paused = True
            self._cancel_flush_locked()
        log.debug("SequenceEngine paused (silent)")

    def resume(self):
        """Program the current cycle + period and start switching.
        Resume is a user-initiated action — skip debounce, fire immediately.
        _resume_time is set by _program_and_go AFTER the G command lands,
        so the Pi-side step estimate is synchronized with actual firmware
        timing rather than offset by the C+F+G serial round-trip (~20-50 ms)."""
        with self._lock:
            self._paused = False
            self._period_us = self._compute_period_us_locked()
            self._cancel_flush_locked()
        self._program_and_go()
        log.debug("SequenceEngine resumed")

    def resume_live(self):
        """Like resume() but uses the live reprogram path (E command)
        so FETs are never turned off during the transition."""
        with self._lock:
            self._paused = False
            self._period_us = self._compute_period_us_locked()
            self._cancel_flush_locked()
        self._program_and_go_live()
        log.debug("SequenceEngine resumed (live)")

    def stop(self):
        """Alias for pause — kept for API compatibility with the old thread
        version that had a distinct shutdown."""
        self.pause()

    def get_state(self):
        """Snapshot for status broadcasts. FET states are computed from the
        live sequence + estimated step while running; during pause we report
        whatever the GPIO cache says (mode controller may have set them
        directly, e.g. all-on during DISCHARGE)."""
        return self._get_state_at(None)

    def get_state_at(self, sample_pi_s):
        """Like ``get_state`` but uses ``sample_pi_s`` (a Pi-monotonic
        timestamp) as the "now" for step estimation. Used by the recorder
        to label each captured row with the step that was *actually live*
        at sample-capture time, rather than at D-line receive time. With
        ~4.5 ms emit latency, ``monotonic()``-based labelling lags reality
        by up to a full step at 100 Hz, inverting the labels.
        """
        return self._get_state_at(sample_pi_s)

    def _get_state_at(self, sample_pi_s):
        with self._lock:
            paused = self._paused
            sequence_idx = self._sequence_index
            freq = self._frequency
            if paused:
                step = self._step_at_resume
                fet_tuple = None  # signal: pull from gpio below
            else:
                packed_seq = self._current_packed_sequence_locked()
                step = self._estimate_step_locked(now=sample_pi_s)
                fet_tuple = _unpack(packed_seq[step])
        if fet_tuple is None:
            fet_states = self._gpio.get_fet_states()
        else:
            fet_states = list(fet_tuple)
        return {
            "sequence": sequence_idx,
            "step": step,
            "frequency": round(freq, 2),
            "fet_states": fet_states,
        }

    # -- internals ----------------------------------------------------------

    def _compute_period_us_locked(self):
        """Pi-side math preserved from the old busy-wait engine: for a
        4-step sequence, step_time = (1/f)/2 so one per-FET toggle cycle
        spans the full period; pulse mode uses 2 steps with doubled time."""
        step_time_s = (1.0 / self._frequency) / 2.0
        if self._pulse_mode:
            step_time_s *= 2.0
        return max(50, int(step_time_s * 1_000_000))

    def _current_packed_sequence_locked(self):
        if self._pulse_mode:
            indices = PULSE_CHARGE_SEQUENCE
        else:
            indices = SEQUENCES[self._sequence_index]
        return [_pack_state(STATE_DEFS[i]) for i in indices]

    def _estimate_step_locked(self, now=None):
        """Compute current step index from elapsed time since the last
        resume/freq-change. Not exact, but good enough for TUI display.

        ``now`` defaults to ``monotonic()`` (status broadcasts, debug
        queries). The recorder passes the per-row sample-capture time
        (translated from the firmware's ticks_us stamp) so each CSV row
        gets the step that was live when the INA226s actually sampled,
        not when the D line landed on the Pi (~4.5 ms later)."""
        packed = self._current_packed_sequence_locked()
        n = len(packed)
        if n == 0 or self._period_us <= 0:
            return 0
        if now is None:
            now = monotonic()
        elapsed_us = int((now - self._resume_time) * 1_000_000)
        ticks = elapsed_us // self._period_us if elapsed_us > 0 else 0
        return (self._step_at_resume + ticks) % n

    def _program_and_go(self):
        """Send C + F + G to the firmware. Called outside the lock so the
        (potentially blocking) serial round-trip doesn't hold up get_state().

        Right before G, we re-sync the Pi↔firmware clock with a P round-trip.
        gpio_driver.start_switching() then anchors _resume_time DIRECTLY off
        the firmware's ticks_us stamp (translated through the freshly-measured
        offset) instead of the Pi's midpoint estimate. Asymmetric latency in
        the firmware's stdin-poll loop fooled the midpoint anchor — symptom
        was 100 Hz inverting while 10/200 Hz aligned in the 2026-04-24 DOE.
        One extra ~5–10 ms round-trip per freq change is acceptable since
        set_frequency edits are debounced 150 ms anyway."""
        with self._lock:
            packed = self._current_packed_sequence_locked()
            period_us = self._period_us
        self._gpio.program_sequence(packed)
        self._gpio.set_step_period_us(period_us)
        # Refresh the clock offset right before G so the anchor reflects
        # current Pi/firmware drift, not whatever was measured minutes ago.
        try:
            self._gpio.sync_firmware_clock()
        except Exception:
            log.exception("sync_firmware_clock failed; falling back to midpoint anchor")
        anchor_pi_s, _fw_ticks = self._gpio.start_switching()
        with self._lock:
            self._step_at_resume = 0
            # Fall back to monotonic() if start_switching returned None
            # (e.g. serial error); the fallback reintroduces the old lag
            # but at least keeps the engine running.
            self._resume_time = anchor_pi_s if anchor_pi_s is not None else monotonic()

    def _program_and_go_live(self):
        """Like _program_and_go but uses E (live reprogram) instead of C.
        The switching timer may already be running (from a previous all-on
        cycle); E swaps the sequence without halting, then G restarts the
        timer with the new sequence.  No all-off gap.

        Skips sync_firmware_clock() to avoid an extra blocking round-trip
        that causes sample gaps at high streaming rates — the clock offset
        from the initial connect is good enough for auto-follow."""
        with self._lock:
            packed = self._current_packed_sequence_locked()
            period_us = self._period_us
        self._gpio.program_sequence_live(packed)
        self._gpio.set_step_period_us(period_us)
        anchor_pi_s, _fw_ticks = self._gpio.start_switching()
        with self._lock:
            self._step_at_resume = 0
            self._resume_time = anchor_pi_s if anchor_pi_s is not None else monotonic()

    # -- debounce -----------------------------------------------------------

    def _schedule_flush_locked(self):
        """Reset the debounce timer. Called with self._lock held."""
        if self._flush_timer is not None:
            self._flush_timer.cancel()
        self._flush_timer = threading.Timer(_DEBOUNCE_S, self._flush)
        self._flush_timer.daemon = True
        self._flush_timer.start()

    def _cancel_flush_locked(self):
        """Drop any pending flush. Called with self._lock held."""
        if self._flush_timer is not None:
            self._flush_timer.cancel()
            self._flush_timer = None
        self._pending_period = False
        self._pending_cycle = False

    def _flush(self):
        """Fires after the debounce window. Both cycle and period changes
        route through _program_and_go (C+F+G) so firmware _seq_idx resets
        to 0 and _step_at_resume latches to 0 at the moment G lands.

        A period-only F update latches a drift of
            debounce × (1/new_period − 1/old_period)
        step-ticks — during the debounce the Pi estimates with the new
        period while firmware is still at the old one, and that error gets
        written into _step_at_resume at flush time. On a 2-step pulse
        sequence, odd drift shows up as phase-inverted labels in the DOE
        (5/10 Hz inversion seen on 2026-04-24). Always C+F+G avoids it at
        the cost of a <20 ms restart glitch per freq change, which the
        150 ms debounce already hides for rapid tweaks."""
        with self._lock:
            if self._paused:
                self._pending_period = False
                self._pending_cycle = False
                self._flush_timer = None
                return
            pending = self._pending_cycle or self._pending_period
            self._pending_period = False
            self._pending_cycle = False
            self._flush_timer = None
        if not pending:
            return
        try:
            self._program_and_go()
        except Exception:
            log.exception("debounced flush failed")


def _unpack(packed):
    """Inverse of _pack_state — returns a 4-tuple of bools."""
    return (
        bool((packed >> 3) & 1),
        bool((packed >> 2) & 1),
        bool((packed >> 1) & 1),
        bool(packed & 1),
    )
