PMantix/Switch_Charging_V2/server/auto_follow.py

"""
Switching Circuit V2 - Auto-Follow Controller.

Watches the cycler-current estimate (KCL on the HV bus, via
CyclerDetector) and toggles between a user-selected switching mode
and "discharge" (all FETs on, transparent) using two-threshold
hysteresis.

Direction-aware: only positive (charging) current above i_enter
engages switching. Negative current (discharge), rest, or low-current
CV taper all leave the FETs in pass-through, which is the natural
state when no switching circuit is between cycler and cells.

Lifecycle: a single daemon thread polls sensor data at AUTO_FOLLOW_LOOP_HZ.
The thread runs whenever the controller is started; the `enabled` flag
gates whether transitions actually fire.
"""

from __future__ import annotations

import logging
import threading
from time import sleep
from typing import Callable, Optional

from server.config import (
    AUTO_FOLLOW_I_ENTER_A,
    AUTO_FOLLOW_I_EXIT_A,
    AUTO_FOLLOW_LOOP_HZ,
)
from server.cycler_detector import CyclerDetector

log = logging.getLogger(__name__)


ALLOWED_TARGET_MODES = ("charge", "pulse_charge")


class AutoFollow:
    """Hysteresis-based mode switcher driven by cycler current."""

    def __init__(
        self,
        get_sensor_data_fn: Callable[[], dict],
        set_mode_fn: Callable[[str], None],
        i_enter_a: float = AUTO_FOLLOW_I_ENTER_A,
        i_exit_a: float = AUTO_FOLLOW_I_EXIT_A,
        loop_hz: float = AUTO_FOLLOW_LOOP_HZ,
    ):
        if i_enter_a <= i_exit_a:
            raise ValueError(
                f"i_enter ({i_enter_a}) must be greater than i_exit ({i_exit_a})"
            )
        self._get_sensor_data = get_sensor_data_fn
        self._set_mode = set_mode_fn
        self._detector = CyclerDetector()  # used only for its KCL avg_current

        self._lock = threading.Lock()
        self._enabled = False
        self._i_enter_a = float(i_enter_a)
        self._i_exit_a = float(i_exit_a)
        self._target_mode = "charge"
        self._is_active = False
        self._latest_avg_i = 0.0
        self._latest_avg_v = 0.0
        self._cc_setpoint_a = 0.0  # user-specified CC setpoint for recommendations
        self._holdoff_until = 0.0  # monotonic time until which exit checks are suppressed
        self._holdoff_s = 2.0     # seconds to suppress exit after entering switching

        self._loop_period = 1.0 / float(loop_hz)
        self._thread: Optional[threading.Thread] = None
        self._stop_event = threading.Event()

    # -- lifecycle -----------------------------------------------------------

    def start(self):
        if self._thread and self._thread.is_alive():
            return
        self._stop_event.clear()
        self._thread = threading.Thread(
            target=self._run, name="AutoFollow", daemon=True,
        )
        self._thread.start()
        log.info("AutoFollow: thread started")

    def stop(self):
        self._stop_event.set()
        if self._thread:
            self._thread.join(timeout=2.0)
        self._thread = None
        log.info("AutoFollow: thread stopped")

    # -- configuration -------------------------------------------------------

    def set_enabled(self, enabled: bool):
        """Enable or disable threshold-driven mode switching.

        On enable: reset to transparent baseline (mode=discharge); next
        loop tick will engage switching if current is already above
        i_enter. This makes "enable auto" deterministic regardless of
        whatever mode was active before.

        On disable: leave the current mode untouched. The user may
        choose to take manual control at the same time by issuing a
        set_mode call externally.
        """
        do_reset = False
        with self._lock:
            was_enabled = self._enabled
            self._enabled = bool(enabled)
            if not was_enabled and self._enabled:
                do_reset = True
                self._is_active = False
            elif was_enabled and not self._enabled:
                self._is_active = False
        if do_reset:
            self._set_mode("discharge")
        log.info("AutoFollow: enabled=%s", enabled)

    def set_thresholds(self, i_enter_a: float, i_exit_a: float):
        if i_enter_a <= i_exit_a:
            raise ValueError(
                f"i_enter ({i_enter_a}) must be greater than i_exit ({i_exit_a})"
            )
        if i_enter_a <= 0:
            raise ValueError(f"i_enter must be positive, got {i_enter_a}")
        if i_exit_a < 0:
            raise ValueError(f"i_exit must be non-negative, got {i_exit_a}")
        with self._lock:
            self._i_enter_a = float(i_enter_a)
            self._i_exit_a = float(i_exit_a)
        log.info("AutoFollow: thresholds enter=%.4f A exit=%.4f A",
                 i_enter_a, i_exit_a)

    def set_cc_setpoint(self, amps: float):
        with self._lock:
            self._cc_setpoint_a = max(0.0, float(amps))
        log.info("AutoFollow: cc_setpoint=%.4f A", amps)

    def set_target_mode(self, mode: str):
        """Update which switching mode auto-follow applies when active.

        If currently engaged, the mode change is applied immediately.
        Modes other than `charge` / `pulse_charge` are silently ignored.
        """
        if mode not in ALLOWED_TARGET_MODES:
            return
        do_apply = False
        with self._lock:
            if self._target_mode != mode:
                self._target_mode = mode
                if self._enabled and self._is_active:
                    do_apply = True
        if do_apply:
            self._set_mode(mode)
        log.info("AutoFollow: target_mode=%s", mode)

    # -- status --------------------------------------------------------------

    def get_status(self) -> dict:
        with self._lock:
            cc = self._cc_setpoint_a
            status = {
                "enabled": self._enabled,
                "i_enter_a": self._i_enter_a,
                "i_exit_a": self._i_exit_a,
                "target_mode": self._target_mode,
                "active": self._is_active,
                "avg_current_a": round(self._latest_avg_i, 6),
                "avg_voltage_v": round(self._latest_avg_v, 4),
                "cc_setpoint_a": cc,
            }
            if cc > 0:
                status["rec_enter_a"] = round(cc * 0.35, 6)
                status["rec_exit_a"] = round(cc * 0.15, 6)
            return status

    @property
    def enabled(self) -> bool:
        with self._lock:
            return self._enabled

    @property
    def active(self) -> bool:
        with self._lock:
            return self._is_active

    # -- main loop -----------------------------------------------------------

    def _run(self):
        while not self._stop_event.is_set():
            try:
                self._tick()
            except Exception:
                log.exception("AutoFollow: tick failed")
            sleep(self._loop_period)

    def _tick(self):
        from time import monotonic
        sensor_data = self._get_sensor_data()
        if not sensor_data:
            return
        result = self._detector.feed(sensor_data)
        avg_i = result.avg_current
        avg_v = result.avg_voltage
        now = monotonic()

        target = None
        with self._lock:
            self._latest_avg_i = avg_i
            self._latest_avg_v = avg_v
            if not self._enabled:
                return
            if not self._is_active and avg_i > self._i_enter_a:
                target = self._target_mode
                self._is_active = True
                self._holdoff_until = now + self._holdoff_s
            elif self._is_active and avg_i < self._i_exit_a:
                if now < self._holdoff_until:
                    pass  # suppress exit during hold-off
                else:
                    target = "discharge"
                    self._is_active = False

        if target is not None:
            log.info("AutoFollow: -> %s (i=%.4f A)", target, avg_i)
            self._set_mode(target)
