PMantix/Switch_Charging_V2/tui/widgets/left_panel.py

"""
Switching Circuit V2 - Left Panel: Key Bindings Reference.
"""

from textual.widget import Widget
from rich.text import Text


class LeftPanel(Widget):
    """Keyboard controls reference (mode/sequence shown in right panel)."""

    DEFAULT_CSS = """
    LeftPanel {
        width: 100%;
        height: auto;
        padding: 0 1;
    }
    """

    def render(self) -> Text:
        t = Text()

        t.append(" KEY BINDINGS\n", style="bold cyan underline")
        t.append("\n")

        sections = [
            ("FREQUENCY", [
                (" w/s ", "+/- 0.1 Hz"),
                (" e/d ", "+/- 1.0 Hz"),
                (" W/S ", "+/- 10 Hz"),
            ]),
            ("SENSORS", [
                (" / * ", "Rate -/+"),
                ("  j  ", "INA226 AVG"),
                ("  k  ", "Bus-V decim"),
                ("  v  ", "Cycle plot mode"),
                ("  y  ", "Cycle window N"),
                ("  R  ", "Range auto/fixed"),
            ]),
            ("RECORD", [
                ("  l  ", "Start/stop"),
                (" [ ] ", "Duration -/+"),
                ("  O  ", "Offload to Mac"),
            ]),
            ("AUTO-FOLLOW", [
                ("  F  ", "Toggle"),
                ("  T  ", "Cycle target"),
                (" ,/. ", "I_enter -/+1mA"),
                (" ;/' ", "I_exit -/+0.5mA"),
                (" </> ", "CC setpoint"),
            ]),
            ("CALIBRATE", [
                ("  B  ", "INA226 Cal Wizard"),
            ]),
            ("NETWORK", [
                ("  P  ", "Switch Pi"),
                ("  r  ", "Reconnect"),
            ]),
            ("OTHER", [
                (" Tab ", "Toggle panel"),
                ("  ?  ", "Help"),
                ("  q  ", "Quit"),
            ]),
        ]

        for section_name, keys in sections:
            t.append(f" {section_name}\n", style="bold white")
            for key, desc in keys:
                t.append("  ")
                t.append(f" {key} ", style="bold white on dark_blue")
                t.append(f" {desc}\n", style="dim")
            t.append("\n")

        return t
