PMantix/Switch_Charging_V2/tui/widgets/mode_selector.py

"""
Switching Circuit V2 - Mode Selector Widget.

Shows three modes with radio-button style indicator.
"""

from textual.reactive import reactive
from textual.widget import Widget
from rich.text import Text


MODES = ["idle", "charge", "discharge", "pulse_charge", "debug", "auto"]

MODE_KEYS = {
    "idle": "i",
    "charge": "c",
    "discharge": "x",
    "pulse_charge": "p",
    "debug": "g",
    "auto": "a",
}

MODE_LABELS = {
    "idle": "IDLE",
    "charge": "CHARGE",
    "discharge": "DISCHARGE",
    "pulse_charge": "PULSE",
    "debug": "DEBUG",
    "auto": "AUTO",
}

MODE_STYLES = {
    "idle": "bold red",
    "charge": "bold green",
    "discharge": "bold yellow",
    "pulse_charge": "bold magenta",
    "debug": "bold cyan",
    "auto": "bold blue",
}


class ModeSelector(Widget):
    """Radio-button style mode selector."""

    DEFAULT_CSS = """
    ModeSelector {
        width: 100%;
        min-height: 8;
        padding: 0 1;
    }
    """

    mode: reactive[str] = reactive("idle")

    def render(self) -> Text:
        t = Text()
        t.append("  MODE ", style="bold cyan underline")
        t.append("(m to cycle)\n", style="dim")
        t.append("\n")

        for m in MODES:
            selected = (m == self.mode)
            radio = "(\u25cf)" if selected else "( )"  # filled vs empty circle
            style = MODE_STYLES.get(m, "white")
            key = MODE_KEYS.get(m, "?")
            label = MODE_LABELS.get(m, m.upper())

            if selected:
                t.append(f"  {radio} ", style=style)
                t.append(f"{label:<12}", style=f"{style} reverse")
                t.append(f" [{key}]", style="dim")
            else:
                t.append(f"  {radio} ", style="dim")
                t.append(f"{label:<12}", style="dim")
                t.append(f" [{key}]", style="dim")
            t.append("\n")

        if self.mode == "debug":
            t.append("\n")
            t.append("  DEBUG: ", style="bold cyan")
            t.append("1-4", style="bold white")
            t.append(" toggle P1/P2/N1/N2\n", style="dim")

        return t

    def watch_mode(self, _: str) -> None:
        self.refresh()
