PMantix/Switch_Charging_V2/(commit log)

2026-03-27 Add switching circuit test script for H-bridge LED control
    GPIO test script that cycles through 4 transistor states (Q1-Q4) to drive LEDs via an H-bridge configuration, testing each polarity combination.
2026-03-29 Add client-server architecture with Textual TUI for H-bridge control
    Server (Raspberry Pi):
    - Modular design: config, GPIO driver (with mock fallback), sequence engine,
    mode controller with dead-time interlock, TCP JSON command server
    - 4 modes: idle, charge, discharge, pulse_charge (alternates two battery paths)
    - 8 switching sequences, 0.1-300 Hz frequency control
    - Rotary encoder + TM1637 display support preserved from V1
    TUI Client (host machine):
    - Three-column Textual layout: state reference + keys (left), detailed ASCII
    H-bridge schematic (center), status + controls (right)
    - Circuit diagram shows N-channel MOSFETs with D/G/S, UCC5304 gate drivers,
    Pi GPIO connections, and pouc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
2026-04-06 Add auto-start, Pi auto-discovery, and debug mode for FET testing
    - systemd service for auto-starting server on Pi boot
    - TUI auto-discovers Pi via cached IP, mDNS, or link-local subnet scan
    - Debug mode (g) lets you toggle individual FETs with keys 1-4 to verify pin assignments
    - Add =/- key bindings for fine frequency adjustment
    - Add debug and pulse_charge modes to all UI panels
    [circuit_diagram.py, command_server.py, config.py, left_panel.py, mode_controller.py]
2026-04-09 Add RP2040 firmware, INA226 sensing, streaming telemetry, and data logging
    Major changes across the full stack:
    RP2040 firmware (firmware/main.py):
    - MicroPython firmware for RP2040-Zero driving UCC5304 gate drivers
    - Serial command protocol: FET control, sensor reading, streaming mode
    - INA226 I2C sensor reading for all 4 H-bridge legs (P1@0x40, P2@0x41, N1@0x43, N2@0x45)
    - Push-based streaming at configurable rates up to ~100Hz
    - Burst recording mode for high-speed captures in RAM
    - NeoPixel status LED (blue=idle, green=active, cyan=streaming)
    Server (Pi-side):
    - GPIO driver rewritten for RP2040 serial with reader thread architecture
    - Sensor data pushed from RP2040 stream, no more stale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
2026-04-12 Add auto mode with cycler state detection, schedule engine, and TUI integration
    Implements cycler-synchronized switching that detects CC charge, CV charge,
    rest, and discharge states from INA226 sensor readings and automatically
    applies the correct MOSFET switching pattern per a user-defined schedule.
    Key features:
    - CyclerDetector with multi-criteria CV detection, hysteresis, and debouncing
    - JSON schedule format with per-step timeout, on_timeout (wait/advance/abort),
    grace periods, and semantic validation
    - AutoEngine daemon thread with sense windows, transition detection, event
    ring buffer, and heartbeat logging
    - Schedule preview/edit screen with step table before starting auto mode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
    [auto_panel.py, circuit_diagram.py, command_server.py, config.py, connection_bar.py, cycler_detector.py]
2026-04-21 Add PCB design files, docs, and gitignore
    Commits the KiCad project for switching_circuit_v2 (schematic, PCB,
    fab outputs, custom symbol/footprint library) along with schematic
    spec, RP2040 ADC upgrade doc, and a gitignore that excludes macOS
    cruft, Claude Code settings, and KiCad auto-backups/history.
    [Switching_Circuit_BOM.csv, bom.csv, bom_jlc.csv, positions_jlc.csv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]
2026-04-22 Let the TUI run on the Pi itself and add Windows discovery support
    When running on a Raspberry Pi (detected via /proc/device-tree/model),
    discovery now probes localhost first. This makes `python -m tui` work
    out of the box over Pi Connect's remote shell with no network setup.
    Link-local subnet scanning also now parses Windows `ipconfig` output
    and prefers `socket.gethostbyname_ex` when available, so auto-discovery
    works for Windows clients on a direct-ethernet link.
2026-04-22 Add WiFi fleet discovery, AP-mode flip, and auto-reconnect to the TUI
    [command_server.py, fleet.py, fleet_list.py, network_mode.py]
2026-04-23 Add E2E latency probe and tune TUI render path
    Introduces a LatencyProbe with rolling p50/p95/max for net / queue /
    apply / plot / total timers, wired from the Pi-side state emit through
    to _apply_state completion. Pi broadcasts gain a t_emit_ns field and
    respond to ping with pong events; a background worker re-measures
    offset via min-RTT/2 every 60s so the net timer survives session-long
    clock drift. Toggle with D; ConnectionBar shows a compact readout.
    Alongside the probe, three TUI-side tuning changes: shorten the
    startup warmup from 0.8s to 0.2s, add a JSON-key Text cache to
    AutoPanel so stable-dict ticks skip the render, and split SensorPlot
    push_data into append_data + commit so the r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
    [auto_panel.py, command_server.py, connection_bar.py, sensor_plot.py]
2026-04-23 Offload CSV and JSONL writes to daemon writer threads
    Pi broadcast loop and TUI UI thread previously did synchronous file
    I/O on every state event at 15 Hz. Per measured overhead, the new
    producer-side cost of queuing a record is ~5 us; the writer thread
    handles all open/write/flush/close. Queue is unbounded (multi-minute
    disk stalls stay under a few MB) with a one-shot warning if depth
    ever exceeds 1000 rows. Graceful stop drains via sentinel with a
    5s join timeout and a warning on overrun.
    Applies the same pattern to PiRecorder, DataLogger, and AutoLogger
    for consistency. Auto-stop on max_samples signals the writer without
    blocking the broadcast loop.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
    [recorder.py]
2026-04-23 Let user join any known fleet AP; overlap WiFi scan with discovery
    macOS system_profiler returns a stale cache of visible SSIDs, so a Pi
    in AP mode (pi_SW#) may not appear even though it's broadcasting. Two
    fixes so the TUI handles this without a manual WiFi switch:
    A. action_join_selected no longer requires entry.online; any entry
    in the fleet list can be join-attempted. networksetup will error
    in ~15s if the AP really isn't in range, and we surface that
    error — much better than the silent refusal we had before.
    B. on_mount kicks off a WiFi scan in parallel with auto-discovery
    and caches the result on the app instance. When discovery fails
    and ConnectDialog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
2026-04-23 RP2040: firmware-resident switching timer (C/F/G/H/K commands)
    Adds a main-loop polled switching timer using time.ticks_us so the
    RP2040 can cycle through an arbitrary-length packed-state sequence
    without Pi-side per-step commands. The Python SequenceEngine
    polling loop was capping real switching at ~20-50 Hz even when the
    TUI asked for 300 Hz; with this in place the RP2040 handles all
    timing itself and the Pi just programs the cycle (C), sets the
    step period (F), and issues Go/Halt/tick (G/H/K).
    S auto-halts the switching timer so manual control and periodic
    switching can't fight. F preserves seq_idx so a mid-run frequency
    change biases the current step short or long but never restarts
    the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
    [main.py, test_switching.py]
2026-04-23 Extend fast-switching test phase with clear LED-watch prompt
    The 4s window was too short and competed with terminal output
    for attention. Now prints a 3-2-1 countdown so the operator can
    look at the circuit before switching starts, and holds 10s.
    [test_switching.py]
2026-04-23 RP2040: move switching tick to machine.Timer (ISR-driven)
    The main-loop polled version worked functionally but the LEDs showed
    faint visible pulsing at 300 Hz because loop overhead (stdin polling,
    occasional GC) added jitter around the 833 us step period. Moving
    switching onto machine.Timer with Timer.PERIODIC runs the tick in
    IRQ context, decoupling timing from anything else the Python loop
    is doing. Callback is allocation-free and caches _seq locally against
    concurrent reassignment from a C command.
    G / F / H still have the same public semantics; main loop no longer
    has a switching-tick branch, and the idle sleep is unconditional
    now that switching no longer depends on tight polling.
    Co-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
    [main.py]
2026-04-23 RP2040: swap stdin select for pre-allocated uselect.poll
    select.select([sys.stdin], [], [], 0) allocates three fresh lists on
    every main-loop iteration. At the ~10 kHz iteration rate the loop
    runs when switching is idle, that's enough garbage to trigger a
    MicroPython GC every ~250 ms — the exact fingerprint of the 4 Hz
    flicker seen at 300 Hz Timer-driven switching, since GC pauses
    queue up Timer callbacks that then fire in a burst.
    Replace with uselect.poll registered once at startup; poll(0) on a
    pre-existing poll object reuses its internal state and doesn't
    allocate in the steady case. Added a gc.collect() just before
    entering the loop so we start with a clean heap.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
    [main.py]
2026-04-23 RP2040: switch poll() to ipoll() for allocation-free stdin check
    poll(0) returns a fresh list per call even when nothing is ready;
    ipoll(0) returns a reusable iterator and doesn't allocate on the
    hot path. Should eliminate the last trickle of garbage and the
    ~1 Hz residual GC-driven stutter at high switching frequencies.
    [main.py]
2026-04-23 SequenceEngine: program RP2040 timer instead of polling switches
    Deletes the Python busy-wait loop that was ticking the H-bridge per
    USB round-trip and capping real switching at ~20-50 Hz. The RP2040
    firmware now owns periodic switching via machine.Timer (previous
    commits); this change rewires the Pi side to just program the cycle
    (C), step period (F), and issue Go/Halt (G/H). set_frequency while
    running sends F without reprogramming the cycle so the firmware
    preserves its seq_idx — biasing the current step short or long,
    per the design.
    get_state() now estimates the current step from elapsed monotonic
    time since the last resume or frequency change. The estimate drifts
    slightly from the f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
    [gpio_driver.py, sequence_engine.py]
2026-04-23 CommandServer: raise broadcast sendall timeout from 50ms to 2s
    The 50ms per-client timeout was hair-triggered by any transient
    WiFi retry or Mac-side render blip — one 100ms hiccup would evict
    the subscriber, the TUI would reconnect, then die again seconds
    later in the same way. Visible as "works fine for a few seconds,
    then crashes out."
    2s is generous enough to absorb realistic transients while still
    evicting a genuinely hung client. Can't safely retry on timeout
    because sendall may have partially written; corrupting the JSON
    framing would kill the connection just the same.
    [command_server.py]
2026-04-23 Fix TUI connection degrading over seconds into disconnection
    Three pile-on fixes for the same symptom (fresh connect works,
    leaving it open lags to no-updates and then drops):
    1. TCP_NODELAY on accepted client sockets. Small state-frame writes
    were sitting up to 200ms for Nagle to flush; combined with the
    Mac's delayed ACKs this is the classic 100s-of-ms pseudo-latency
    pathology. Small change, should visibly cut net latency.
    2. Default broadcast rate 15 Hz -> 5 Hz. 15 Hz was overwhelming the
    Mac Textual render loop — each frame drove a full render pass,
    and sustained consumption couldn't keep up. Backpressure built
    in TCP buffers until sendall timed out and the connecti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
    [command_server.py]
2026-04-23 CommandServer: restore default broadcast rate to 15 Hz
    Lowering to 5 Hz was counterproductive — sparse traffic over WiFi
    triggers radio power-save and TCP congestion-window collapse, both
    of which add per-packet latency that accumulates in the send buffer
    until the connection dies. The user confirmed empirically that
    raising the sensor rate (which raises broadcast rate) eliminates
    the "dies in seconds" symptom entirely. Comment added to the code
    so this mistake isn't re-made.
    [command_server.py]
2026-04-23 Pi provisioning: check in AP/power-button services for fleet duplication
    Adds the Pi-side files that previously existed only on pi-SW1, so new
    Pis (pi-SW2, pi-SW3, ...) can be provisioned from the repo. SSID/profile
    already derive from hostname via fleet.my_ap_profile(), so no per-Pi
    code changes are needed — just set the hostname before install.
    - server/ap_fallback.py: boot-time AP activation. Rewritten to enter AP
    mode immediately on boot instead of waiting 30s for a client profile.
    Double-press on the PWR button still toggles to client mode.
    - server/power_button.py: evdev listener for the Pi 5 PWR button;
    double-press within 0.5s toggles AP <-> client and restarts
    rpi-connect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
2026-04-23 Share .claude/skills/ in repo; add new-pi provisioning skill
    Previously .claude/ was ignored wholesale, so operator-local skills stayed
    off GitHub. For fleet operations (provisioning, deploy, check-hw) it's
    useful to have shared skills travel with the repo so any operator or any
    clone of this repo picks up the same rituals.
    - .gitignore: ignore .claude/* contents but re-include .claude/skills/
    (settings.local.json and session state stay local).
    - .claude/skills/new-pi: new skill to provision a fresh Pi 5 as a fleet
    member. Sets hostname, creates the pi_SW# NetworkManager AP profile
    from <new-hostname>, installs system deps, clones the repo to
    /home/pi/Code/Switch_Charging_V2, instal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
2026-04-23 CommandServer: raise default broadcast floor to 30 Hz (keep-pipe-warm)
    DOE across 10 runs × 5 rates confirmed: sparse traffic is worse than
    dense traffic over WiFi. At DEFAULT=15, a sensor rate of 2 Hz left
    the broadcast at 15 Hz and produced p95 latencies around 78 ms; at
    DEFAULT=30 the same scenario drops to ~44 ms. 30 Hz saturates the
    WiFi radio / TCP window benefit — pushing further (MAX=60) produced
    DEAD sweeps on both 50 and 60 Hz broadcast, showing 30 is the firm
    Mac-side ceiling for this stack.
    Net effect: users who haven't manually bumped sensor rate now get
    the same low-latency feel as if they had. No API change.
    Adds tools/rate_sweep.py for reproducing the measurement.
    Co-Au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
2026-04-24 Debounce rp2040 serial + disable TUI mouse tracking
    Two independent polish fixes:
    1. SequenceEngine: debounce set_frequency / set_sequence /
    set_pulse_mode. Internal state (and therefore the status
    broadcast) updates immediately so the TUI feels instant, but
    the actual F / C+F+G serial commands to the RP2040 are
    coalesced with a 150ms trailing-edge timer. A held `w` key that
    previously fired ~30 serial round-trips per second — saturating
    ttyACM0 and pausing sensor streaming — now results in one
    update at the end of the burst.
    2. SwitchingCircuitApp: disable terminal mouse tracking in
    on_mount via driver._disable_mouse_support(). The TUI is
    purely keyboard-dri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
    [sequence_engine.py]
2026-04-24 DataLogger: stop flow in worker thread + fix Pi host lookup
    Two bugs in the end-of-duration path:
    1. _stop_pi used `pi@raspberrypi.local` for ssh/scp, but mDNS
    doesn't reliably resolve over the pi_SW1 AP network. When it
    can't resolve, ssh waits ~10s and scp waits another 30s before
    giving up — ~50s of dead time. Now uses the PiClient's actual
    connected host (e.g. 10.42.0.1 in AP mode) with explicit
    ConnectTimeout=3, StrictHostKeyChecking=no, and BatchMode=yes
    so it fails fast if auth would prompt.
    2. _on_recording_done called DataLogger.stop() on the UI thread,
    so the scp+ssh round trips froze the TUI. Now the stop runs on
    an executor thread via run_worker; the c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
2026-04-24 Plotting + automated recording DOE for sampling-vs-switching analysis
    Two tools for the measurement-quality study:
    tools/plot_recording.py — reads one or many recording CSVs and
    renders a 3-panel plot: overlaid V traces for P1/P2/N1/N2,
    overlaid I traces, and stepped FET-state traces below. Usable
    interactively or batch via --save.
    tools/recording_doe.py — command-only TCP client (doesn't
    subscribe, so it doesn't contend with the broadcast loop)
    that iterates switching × sampling combinations, records
    each for a fixed duration via the existing Pi-record flow,
    and SCPs results back. Default matrix is 4×5 at 10 s each.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
2026-04-24 Pi recording now runs regardless of subscribers
    The broadcast loop skipped the recorder.record() call when no TUI
    was subscribed, because the `if not self._subscribers: continue`
    check came before the recording call. That silently produced
    header-only CSVs for command-only clients (recording_doe.py). Fixed
    by doing recorder.record() on every tick, with the subscriber
    check only gating the actual broadcast send.
    Also makes plot_recording.py tolerant of empty CSVs (prints a skip
    message instead of crashing on .iloc[0]).
    [command_server.py]
2026-04-24 RP2040: coalesce sensor-stream format to one allocation per frame
    emit_stream_line used to build a list of 8 f-string formatted parts
    then join them plus concat the "D " prefix — ~9 string allocations
    per call. At 200 Hz sensor streaming (as in recording_doe.py runs)
    this filled the MicroPython heap to the GC threshold about once
    per second, and each GC pause delayed the switching Timer callback
    long enough to produce the "subtle flicker every 1s" the user
    reported. Swapping for one %-format reduces the allocation count
    from 9 → 1 per frame. Verified against the same pattern that
    fixed the main-loop flicker (uselect.poll + ipoll).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
    [main.py]
2026-04-24 Decouple Pi recording rate from broadcast rate
    Previously recording lived inside the broadcast loop, so even at 200
    Hz sensor streaming the actual CSV was written at the 30 Hz broadcast
    cap — useless for capturing switching transients at 100-300 Hz where
    we need sub-cycle resolution. Moved recording to a gpio_driver
    on_sensor_tick callback invoked by the serial reader thread on every
    fresh D frame. Recording rate now tracks sensor rate directly;
    broadcast stays on its TUI-friendly cadence.
    Downstream impact: nil for TUI latency (broadcast unchanged) and
    firmware (unaffected). Minor reader-thread CPU bump at 200 Hz
    (~5% estimated). Recording timestamps now reflect sensor arrival,
    not broad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
2026-04-24 Add DOE grid visualisation — commanded vs sensed per condition
    tools/plot_doe_grid.py tiles all (switching × sampling) recordings
    in one figure. Each tile overlays the commanded FET-ON step in
    light grey with the sensed current trace in red, on a single axis.
    Title annotations show:
    - samples/cycle (Nyquist indicator)
    - on/off discrimination Δ = (I_on - I_off) / I_max
    - colour code: green clean, orange marginal, red aliased
    Makes the interaction between switching rate and sampling rate
    visually immediate for the DOE.
2026-04-24 Add per-file commanded-vs-sensed detail plot
    tools/plot_cmd_vs_sense.py: one subplot per FET (P1/P2/N1/N2),
    with commanded ON state as a grey step-fill, sensed current in
    red (primary y-axis), and sensed voltage in blue on a secondary
    right-side y-axis. Title on each subplot shows samples/cycle,
    I_on / I_off, and discrimination Δ = (I_on - I_off) / I_max.
    Interactive by default (omit --save to get the matplotlib
    toolbar with pan/zoom, which is the main reason for this tool —
    the DOE grid is readable at a glance but too dense to inspect
    individual transients).
2026-04-24 DOE: cycle-based capture + cycle-based grid x-axis
    recording_doe.py gains --cycles N, which sets per-condition duration
    to N switching periods (floored by --min-duration, default 1.0s).
    This lets you capture the same number of cycles at every switching
    rate — a 1 Hz and a 100 Hz recording both contain e.g. 5 cycles —
    so back-to-back visual comparison across switching rates is fair.
    plot_doe_grid.py gains --x-axis {seconds,cycles} and --max-cycles N.
    "cycles" mode plots time × switching_hz on the x, so every tile
    shows the same number of cycles per unit x regardless of switching
    rate. Combined with --max-cycles, every tile is clipped to the
    same width — direct apples-to-apples alignme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
2026-04-24 DOE: iterate switching inside sampling for video-friendly ordering
    Swap the loop order so switching frequency (which drives the visible
    LED blink pattern) changes on each inner iteration instead of once
    per sampling-rate outer pass. Makes the circuit interesting to watch
    while a DOE is running.
2026-04-24 recording_doe: --mode flag + correct cycle multiplier
    Adds --mode {charge,discharge,pulse_charge} so the DOE can exercise
    pulse_charge without hand-editing the script. Also fixes the cycles
    → duration math: a full sequence cycle spans 2 × step_time under the
    current engine formula, so --cycles N now produces N actual cycles
    (previously it gave N/2).
2026-04-24 Sync step tracker with actual firmware start, not Pi-call time
    sequence_engine: _resume_time was captured before _program_and_go
    fired the C+F+G commands, so Pi's step estimate ran 20-50 ms ahead
    of the RP2040's actual switching. Visible in DOE grid as the sensed
    current trace shifting relative to the commanded grey step at high
    switching rates (5 Hz showed a full-cycle phase inversion). Now
    _program_and_go captures _resume_time and resets _step_at_resume=0
    AFTER start_switching() returns, locked to firmware reality.
    The debounced flush path resyncs similarly for both cycle-reprogram
    and period-only cases.
    recording_doe: wait 250 ms after set_frequency/set_sensor_rate so
    the engine's 150 ms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
    [sequence_engine.py]
2026-04-24 Unify period-only flush with cycle flush (always C+F+G)
    Period-only F update latched a drift of
    debounce × (1/new_period − 1/old_period) step-ticks because the Pi
    estimated with the new period during the 150 ms debounce while firmware
    stayed at the old period. On a 2-step pulse sequence, odd drift flipped
    the state label. DOE on 2026-04-24 showed 5/10 Hz with Δ ≈ −0.9 —
    currents were fine, only the step/p1_on/p2_on columns were inverted.
    Both paths now route through _program_and_go, which resets firmware
    _seq_idx to 0 and captures _resume_time after G lands. Cost: ~10-20 ms
    restart glitch per frequency change, absorbed by the existing 150 ms
    debounce on rapid tweaks.
    Co-Authored-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
    [sequence_engine.py]
2026-04-24 Add INA226 sensor profile: runtime AVG + bus-voltage decimation
    New firmware commands:
    A <avg> set INA226 averaging (1/4/16/64/128/256/512/1024)
    V <every> read bus voltage every Nth shunt sweep (0 = never)
    M report current AVG/every and computed max stream rate
    Lifts the hardcoded 200 Hz sensor stream cap — firmware now computes
    the cap from AVG × (VSHCT + VBUSCT) and the I²C sweep time, and echoes
    it in OK A/V/T replies so callers can clamp intelligently.
    Stream path decimates bus-voltage reads but keeps the D-line schema
    fixed by caching the last bus value between reads. INA226 stays in
    continuous shunt+bus mode, so the saving is I²C time, not chip cycles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
    [command_server.py, gpio_driver.py, main.py, sensor_plot.py]
2026-04-24 TUI: make AVG / bus-decim controls visible and document in help
    Three fixes after initial build:
    - Header renders avg= and bus-decim values in bold yellow instead of
    dim so they don't disappear into the surrounding muted text.
    - Show the j/k key hints in the header's inline key-legend row, and
    add a SENSORS & PLOT entry to the Help screen (? to open).
    - Explicit plot.refresh() after changing profile so the redraw is
    immediate instead of waiting up to 70 ms for the next sensor-data
    render tick. The reactive repaint path is a no-op when the value
    didn't actually change (e.g. repeated presses under a round-trip
    race), which made the feature feel unresponsive.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
    [sensor_plot.py]
2026-04-24 TUI: extend sensor-rate ladder to 1 kHz, refine bus-decim steps
    SENSOR_RATES now goes to 1000 Hz — the old 100 Hz ceiling predates the
    runtime-tunable INA226 profile. With AVG=1 the firmware can serve up to
    ~1250 Hz, and CSV recording runs at the sensor rate (plot display still
    caps at 15 fps regardless).
    BUS_EVERY_STEPS: 1/2/3/5/10/off — finer granularity below 5, drops the
    20 step which was too sparse in practice. Firmware still accepts any
    0..1000 via the JSON command; the DOE --bus-every flag bypasses this
    list.
2026-04-24 Attack sample-rate cap, G clock sync, MAX_FREQ cap
    Three problems observed in the 2026-04-24 high-freq DOE, fixed together:
    1) Effective sample rate stuck at ~224 Hz regardless of request.
    Firmware's _max_stream_hz() was reporting theoretical ceilings
    (625-1250 Hz) that didn't account for MicroPython I2C overhead +
    stdout.write + format. Added Z command that times emit_stream_line()
    on-device and caches the measured per-emit microseconds — once Z
    runs, _max_stream_hz returns 1_000_000 / measured_us, the honest
    number. First reading: AVG=4 bus_every=1 is 4508 µs/emit = 222 Hz.
    Also bumped I2C freq 400 kHz → 1 MHz (INA226 rated to 2.94 MHz) so
    sweeps don't bottlen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
    [config.py, gpio_driver.py, main.py, sequence_engine.py, upload.py]
2026-04-24 Firmware clock sync + step-aligned recording + C halts timer
    Three related fixes from the 2026-04-24 inversion-hunt session:
    1. Firmware C command now halts the timer before resetting _seq_idx.
    Prior behaviour: timer kept firing during the C→F→G serial round
    trip (~5-10 ms of stale ticks at 1 kHz prior-rate), advancing
    _seq_idx mod 2 away from 0. G would then come up on state 1
    instead of state 0, flipping the step label of every subsequent
    frame. Halting in C fixes the starting state.
    2. Pi-firmware clock sync via P-ticks_us.
    - P reply now includes time.ticks_us()
    - gpio_driver.sync_firmware_clock() measures offset = fw_us/1e6 -
    midpoint(t_send, t_reply)
    -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
    [gpio_driver.py, main.py, recorder.py, sequence_engine.py]
2026-04-24 Stamp each D line with firmware ticks_us; step label now honest
    The clock-sync fix aligned the G-anchor but 100 Hz still inverted
    because the step field on each recorded row was computed at D-line-
    receive time on the Pi, not sample-capture time on the firmware.
    ~4.5 ms of emit-to-receive lag = ~half a step at 100 Hz switching
    = mod-2 label flip.
    Firmware now prepends time.ticks_us() to each D line. The Pi reader
    translates it to Pi-monotonic via the already-measured _clock_offset_s
    and passes it through a new on_sensor_tick(data, sample_pi_s) signature.
    SequenceEngine gains get_state_at(sample_pi_s) which runs the same
    step-estimation math using the historical sample time instead of
    monoto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
    [command_server.py, gpio_driver.py, main.py, mode_controller.py, sequence_engine.py]
2026-04-24 Bump default INA226 bus_every to 5; add runtime CT (U) and mem (E) commands
    Sweep on 2026-04-24 (AVG ∈ {1,4,16,64} × CT ∈ {140,204,332,588} µs at
    bus_every=5) found the rig is pinned to a ~4 ms/emit format/USB floor:
    sustained rate is ~250 Hz regardless of AVG or CT (best 3904 µs at
    AVG=64/CT=332, worst 4240 µs at AVG=1/CT=140 — 8% spread). Conversion
    and I²C are NOT the bottleneck; lowering them only changes noise.
    Default bus_every: 1 → 5. With AVG=4/CT=332 this moves emit_us from
    4882 → 4093 (≈20% gain, 205 → 244 Hz), and bus voltage decimation is
    invisible in practice because it's the supply rail. Glitches at 500 Hz
    and 1 kHz switching match the no-switching control (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
    [main.py, sensor_plot.py]
2026-04-25 Switch sensor stream to binary frame format (3.16x throughput)
    Replaces the ASCII "D <t_us> <8 floats>\n" line with a 25-byte binary
    frame [0xAA 0x55 'B' 20 <ticks_us:u32> <(shunt:i16,bus:u16)*4> <xor>].
    Float conversion (raw x LSB / shunt_R) moves from firmware to Pi where
    CPU is plentiful; the firmware hot path is now allocation-free
    struct.pack_into into a preallocated 25-byte buffer plus four
    i2c.readfrom_into calls into a preallocated 2-byte mv. Sensor-address
    lookup is hoisted to a list cached at scan time so the per-emit path
    does no dict work.
    The Pi parser becomes a small state machine that hunts for the AA 55
    'B' 20 sync header in a persistent rxbuf, decodes 25-byte frames, and
    ro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
    [gpio_driver.py, main.py]
2026-04-25 Revert "Switch sensor stream to binary frame format (3.16x throughput)"
    This reverts commit 845c40d629db470fae3800e9635b43253fefd44e.
    [gpio_driver.py, main.py]
2026-04-25 Revert "Bump default INA226 bus_every to 5; add runtime CT (U) and mem (E) commands"
    This reverts commit 07ae9a32c0dd21fc98a774da6be56d05c9f97af7.
    [main.py, sensor_plot.py]
2026-04-25 Add C acquisition plan with advisor revisions
    Plan doc covering Phase 1 (binary frame re-land), Phase 1.5
    (profile + CNVR experiments), Phase 2 (C user-C-module), Phase 3
    (SDK rewrite). Advisor revisions applied: timing table marked as
    hypothesis pending split-Z measurement, USB CDC ceiling claim
    weakened, no-allocation rule added to Phase 2 design with
    MICROPY_C_HEAP_SIZE note, pull-up verification promoted to Phase 1
    checklist, MicroPython actual-vs-requested I2C bus rate caveat
    added to hardware risks.
2026-04-25 Add seq number + per-emit profiling instrumentation
    Firmware:
    - Add 32-bit _stream_seq emit counter; reset on T <hz> stream start
    - Wire format: D <fw_ts_us> <seq> <P1v> <P1i> ... (11 fields)
    - Split per-emit cost into i2c_us / fmt_us / write_us phase totals
    via ticks_us/ticks_diff windows
    - Z command now returns: OK Z <n> <avg_us> <i2c_us> <fmt_us>
    <write_us> <max_hz>; backward-compat preserved (extra fields at end)
    Host:
    - gpio_driver._handle_stream_line parses 11 fields; callback now
    cb(data, sample_pi_s, fw_ts_us, seq)
    - profile_emit(n) issues Z and parses both new (8-token) and legacy
    (5-token) replies
    - recorder.record(status, sample_pi_s, fw_ticks_us, fw_seq) anchors
    elapse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
    [command_server.py, gpio_driver.py, main.py, recorder.py]
2026-04-25 profile_emit TCP cmd + measured timing in C plan
    - Expose firmware Z command via TCP cmd "profile_emit" so the host
    can drive split-Z profiling without holding the serial port.
    - Replace the estimated timing table in docs/c_acquisition_plan.md
    Section 1 with measured per-stage µs at 5 configs. Headline:
    I²C reads are 52-63% of every emit, format is 26-34%, USB write
    is 5-6%. The "format dominates" hypothesis is wrong; the historical
    3.16x binary claim is suspect and needs revalidation. CNVR/ALERT
    promoted ahead of binary re-land because at AVG=1 ~5/6 emits read
    the same conversion (correctness fix).
    [command_server.py]
2026-04-25 Add CNVR-driven INA226 read scheduler
    - Configure each INA226 with CNVR=1 in Mask/Enable so ALERT pulls low
    on every conversion-ready (continuous mode).
    - ALERT pins of all 4 chips are wired-OR onto GP27 with a 4.7 kΩ
    pull-up (R_ALERT1) per the schematic. IRQ_FALLING handler sets
    a single global flag, allocation-free.
    - emit_stream_line gates on (user-configured cadence) AND (CNVR
    ready or watchdog timeout). After emit, clears CVRF on every chip
    to release ALERT for the next conversion.
    - Falls back to legacy timer-only path when no INA226s are present
    so boot stays clean.
    Why: at AVG=1 chip cadence is ~1.5 kHz but emit cadence is ~230 Hz,
    so under blind polling about 5 of ever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
2026-04-25 CNVR A/B sweep + comparison plot tools
    - cnvr_ab_sweep.py runs the same DOE conditions twice — pass 1 with
    CNVR disabled, pass 2 with CNVR enabled — and tags the recordings
    cnvroff/cnvron in their filenames so pairs are obvious.
    - plot_cnvr_ab.py takes one off + one on CSV and produces a 3-row
    comparison: P1 current trace, inter-sample dt histogram, and a
    text annotation block with expected vs actual sample counts plus
    the stale-repeat fraction (rows whose 8 raw V/I values exactly
    match the prior row — the headline correctness metric for CNVR).
2026-04-25 CNVR A/B null result; default OFF; pivot plan to C firmware
    A/B sweep across 12 conditions (sw 1..100 Hz, sp 50..200 sps,
    AVG=1, bus_every=5) shows stale-repeat rate ≤0.74% in every
    condition with or without CNVR — the "5/6 stale" hypothesis was
    wrong. INA226 continuous mode overwrites the Shunt register every
    ~664 µs, so a sweep at 200 Hz reads whichever conversion just
    completed (~7 conversions per sweep interval). Stale repeats only
    happen when sweep > chip rate.
    CNVR-on actively loses 5-11% throughput at 200 sps because each
    emit does four extra clear_cnvr register reads (~1.4 ms overhead).
    Default toggled to OFF; N command kept in case a future config
    ever sweeps faster than chip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
    [main.py]
2026-04-25 Add C firmware (Pico SDK) — initial port from MicroPython
    ~1770 lines of C across cmd_parser, ina226, streaming, switching,
    neopixel, usb_cdc, plus CMakeLists and README. Wire format matches
    the post-seq+profiling host parser:
    D <fw_ts_us> <seq> <P1v> <P1i> <P2v> <P2i> <N1v> <N1i> <N2v> <N2i>
    Why a rewrite: profiling on the live rig (2026-04-25) showed I2C is
    52-63% of every emit (3 ms of a 5 ms emit at AVG=4) — i.e. the cost
    is per-machine.I2C.readfrom Python interpreter overhead, not the
    chip. A compiled hot path collapses that to a few hundred µs and
    should clear ~1 kHz/sweep. MicroPython firmware/main.py stays in
    the tree as a fallback during the cutover; both flash to the same
    R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
2026-04-25 Add CLAUDE.md delegation triggers + ignore firmware-c/build & plots/
    C firmware DOE validation passed: ~999 sps delivered at 1000 sps
    requested (4× the MicroPython baseline ceiling), 99.9 samples/cycle
    at 10 Hz switching, and N1/N2 phase alignment is correct (Δ now
    positive everywhere; old MicroPython was inverted by half a cycle
    above ~50 Hz due to sample-rate clamp aliasing).
2026-04-25 TUI/firmware: honest max_hz on connect and after profile changes
    Three coordinated fixes so the TUI header reflects real firmware state:
    1. tui/app.py: pre-subscribe get_sensor_profile after connect. The
    header was sitting on its 376 Hz placeholder until the user
    manually cycled AVG or bus_every. Now it pulls avg/bus_every/
    max_hz/sensor_rate from the firmware on every successful connect.
    Extends _apply_profile_reply to also write avg and bus_every so the
    one helper covers connect bootstrap, set_ina226_avg, and set_bus_every.
    2. firmware-c: streaming_invalidate_measurement() drops the cached
    s_measured_emit_us. cmd_A and cmd_V call it after the profile
    change so stream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
    [cmd_parser.c, config.py, sensor_plot.py, streaming.c, streaming.h]
2026-04-26 TUI: cycle-window x-zoom + sensor-plot polish
    Sensor plot:
    - y key cycles the x-axis zoom: 0→1→2→3→5→10→0 cycles. When >0, the
    filtered last-N-cycles' worth of data is stretched across the full
    plot width (still scrolling left-to-right; not phase-locked).
    - Bar/sparkline mode is now multi-row (bar_row_height=3) instead of a
    single line, and obeys cycle zoom with sample-and-hold so stretched
    bars stay continuous.
    - Big-jump-vs-diagonal heuristic on the braille builder: when the row
    delta exceeds the column delta, draw the dashed-vertical jump line
    at prev_col (this also now fires in dot mode, which previously had
    no connection at all). Otherwise smooth diagonal inter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
2026-04-26 recorder: pi_record_start accepts align_to_step override
    Default (1) waits for a transition into step=1 before capturing the
    first sample so every recording starts at a consistent cycle phase.
    That gate aliases to "never starts" when the sensor sample rate
    happens to land on the same step every frame — e.g. 100 Hz switching
    × 10 or 50 sps in pulse mode produced empty CSVs in today's DOE.
    Pass align_to_step: null in the JSON command to disable the gate
    and begin recording on the first frame regardless.
2026-04-26 TUI: Pi picker — Shift-P to swap active Pi
    Adds a modal that probes all eight pi-SW#.local hostnames in parallel,
    lists live ones with latency (offline ones dimmed), and retargets the
    existing PiClient via reconnect_to. Refuses to switch while a recording
    is active so data isn't silently abandoned.
    - discovery.discover_fleet / FleetHit: full-fleet enumeration
    - widgets/pi_list.PiList: latency-aware list (separate from FleetList
    so the dBm/ms unit conflation stays out of the AP picker)
    - widgets/pi_picker.PiPicker: modal with arrow + 1-8 nav, r rescan
    - app.action_switch_pi + _switch_pi + _reset_pi_state
    [pi_list.py, pi_picker.py]
2026-04-26 auto-mode: KCL-sum cycler current estimate, drop sense windows
    Replace per-active-sensor averaging in CyclerDetector with a KCL estimate
    on the HV bus: avg_i = (P1+P2 + N1+N2) / 2. Gate-state invariant, so
    sensing is continuous and never has to interrupt the active switching
    pattern with a transparent window.
    Removes _do_sense_window / _sense_and_classify and the associated
    SENSE_INTERVAL / SENSE_WINDOW_S constants from auto_engine.py and
    config.py. Also strips the transparent preamble at charge-step entry.
    Test helper _sensor() updated to simulate a realistic single-pair-active
    switch (state 0: P1+N1) so the i argument means cycler current.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
    [config.py, cycler_detector.py, test_cycler_detector.py]
2026-04-26 auto-follow: hysteresis controller + TUI panel (Stage 1)
    Adds a current-threshold-driven mode switcher that runs alongside the
    existing auto/schedule machinery. When enabled, the controller toggles
    between the user-selected switching mode (charge / pulse_charge) and
    "discharge" (all FETs on, transparent) using two-threshold hysteresis:
    - i_enter (default 5 mA): rising +current above this engages switching
    - i_exit (default 2 mA): falling current below this OR negative
    current OR rest drops back to transparent
    Direction-aware — only positive (charging) current engages switching;
    discharge / rest leave the FETs in pass-through, matching the natural
    no-circu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
2026-04-26 tests: guard start_switching against None resp in mock mode
    Mock GPIO _send returns None; resp.split() raised AttributeError, breaking
    set_mode("charge") and auto-mode tests. Return (None, None) early so the
    sequence engine's monotonic() fallback kicks in.
2026-04-26 schedule monitor: passive PLAN | OBSERVED tracker (Stage 2)
    A loaded schedule is now monitored continuously by a separate passive
    observer that does NOT control any modes. The cycler is the master;
    the monitor just walks the schedule on its own time-based clock (PLAN)
    and reports what CyclerDetector currently sees (OBSERVED), letting the
    TUI show whether the cycler is following the program or has diverged.
    Server: server/schedule_monitor.py — own polling thread feeding its
    own CyclerDetector instance. PLAN clock advances by step.timeout_s,
    loops via schedule.repeat. ModeController owns it; load_schedule()
    auto-starts the PLAN clock. New commands: schedule_monitor_status,
    schedule_monitor_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
2026-04-26 auto-mode: drop AutoEngine, collapse to AutoFollow + monitor (Stage 3)
    Delete the schedule-driven AutoEngine (Mode.AUTO) entirely. The
    combination of AutoFollow (current-threshold mode switcher, Stage 1)
    and ScheduleMonitor (passive PLAN/OBSERVED tracker, Stage 2) covers
    both responsibilities the old engine had — and the cycler-as-master
    model is a better fit for how testing actually works.
    Removed:
    - server/auto_engine.py, server/auto_logger.py
    - tests/test_auto_engine.py
    - Mode.AUTO from the enum
    - auto_status / auto_pause / auto_resume / auto_skip_step commands
    and their TUI-client wrappers
    - action_mode_auto / action_auto_skip / pause-resume branch in
    action_toggle_r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
2026-04-26 tools: Neware XML → schedule JSON importer
    Standalone script that translates Neware BTS Step File XML into our
    schedule.py JSON format for the passive ScheduleMonitor. Decoupled
    from the server intentionally — convert offline, eyeball the JSON,
    load via the existing schedule loader.
    Step type mapping (verified against a 270 mAh formation schedule
    where the user confirmed 0.02C and 0.05C charge rates correspond to
    5.43 mA and 13.6 mA):
    1 (CC charge) → cc_charge
    2 (CC discharge) → discharge
    4 (Rest) → rest
    6 (End) → terminator (drops out of list)
    7 (CCCV) → cc_charge (one PLAN step; CV phase surfaces in
    the m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
2026-04-27 auto-follow panel: escape literal [ ] in keybinding hint
    Textual's markup parser was reading '[/]' as a closing tag with
    nothing to open, crashing the panel on first render. Escape the
    brackets and rephrase the hint.
2026-04-27 auto-follow panel: take focus on mount, swap space->enter
    The modal screen had only non-focusable children (Label, Static), so
    focus stayed on the underlying app screen and the modal's BINDINGS
    never fired. Take focus explicitly in on_mount.
    Also swap the toggle key from space to enter. The app-level
    Binding("space", "toggle_run", priority=True) preempts modal
    bindings even when a modal is open, so 'space' in the modal would
    fire toggle_run on the app instead of toggling the auto-follow
    enabled state.
    Bonus: silence the RuntimeError that printed on quit when the
    recv thread tried call_from_thread after the event loop was gone.
    Drop late frames during shutdown silently.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
2026-04-27 auto-follow panel: reactive body widget + broaden shutdown catch
    Static.update() wasn't triggering visible re-renders on the user's
    Textual version (Python 3.9, older release): the action handler ran
    and updated _state, but the panel display stayed frozen. Replace the
    Static body with a custom Widget whose `state` is a reactive dict —
    reactive watchers reliably trigger refresh.
    Also: the dispatch reassigns a NEW dict each refresh (not the same
    dict mutated in place), since reactives only fire on identity
    change.
    Broadened the shutdown-race catch in _on_state_update from
    RuntimeError to Exception. The recv thread was throwing something
    else (NoActiveAppError or similar) when the event loo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
2026-04-27 auto-follow: drop modal, integrate inline in right panel
    Modal approach was fighting Textual on three fronts: BINDINGS
    resolution, focus management, and Static.update() refresh — all
    worked unreliably on the user's Python 3.9 / older Textual. Replace
    with the established inline-widget + global-binding pattern this
    codebase uses everywhere else.
    - Add an AUTO-FOLLOW block to RightPanel showing enabled / target
    / I_enter / I_exit / live current / state, with the keybinding
    chips next to each adjustable field.
    - Add a `auto_follow` reactive on RightPanel; cache key includes
    the load-bearing fields so live-current ticks don't re-render
    unnecessarily.
    - Six new app-level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
    [right_panel.py]
2026-04-27 auto-follow: send-and-forget commands, drop diagnostic notifies
    PiClient.send_command can't correlate command replies back to the
    caller while subscribed to the state stream — it returns a
    {"ok": True} placeholder and the actual server reply gets dropped
    by the recv loop because it has no `event` field. The previous
    _send_auto_follow tried to read auto_follow off that placeholder,
    saw nothing, and bailed.
    Switch to send-and-forget. The next state broadcast (~33 ms) carries
    the updated auto_follow status from the server; the right-panel
    reactive picks it up. Same pattern set_mode / set_sequence already
    use successfully.
    Also strip the diagnostic per-action notifies — they were instrumen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
2026-05-14 fleet network watchdog: auto-join existing AP, failover on disconnect
    Replace the oneshot ap_fallback boot script with a long-running
    watchdog. On boot, each Pi scans for an existing pi_SW# AP — if
    found it joins as a client; otherwise it starts its own AP. While
    in client mode the watchdog pings the gateway and handles failover:
    lowest-numbered survivor promotes itself to AP.
    Adds fleet constants (AP_PASSWORD, FLEET_SSID_RANGE, my_fleet_index)
    and changes the systemd service from Type=oneshot to Type=simple.
    [ap_fallback.py, fleet.py]
2026-05-14 fleet: wifi-ready gate, SW1 always-AP, TUI switch fix + cached picker
    ap_fallback: Wait until the radio sees any WiFi network before doing
    the fleet scan (catches hardware not being ready on fresh boot). SW1
    skips scanning entirely and goes straight to AP mode. Higher-numbered
    Pis bring down any auto-activated AP before scanning.
    TUI: Fix Pi switching — disconnect+reconnect now runs the full
    bootstrap (subscribe + get_sensor_profile) via _do_connect instead of
    the broken reconnect_to path. Clear _stop_event so retry loop runs.
    Show P binding in footer. Cache fleet scan results so the picker
    opens instantly on subsequent uses.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
    [ap_fallback.py, pi_picker.py]
2026-05-14 reduce connection stall impact: non-blocking USB CDC, faster timeouts
    Firmware: set PICO_STDIO_USB_STDOUT_TIMEOUT_US=0 so printf drops data
    instead of blocking 500ms when the Pi stops reading. The main loop
    stays responsive to commands even during host disconnects.
    Pi server: reduce broadcast sendall timeout from 2s to 0.5s — dead
    subscribers get evicted 4x faster instead of stalling the broadcast
    loop. Reduce serial response timeout from 2s to 0.5s — the RP2040
    responds in microseconds, so a 500ms wait is generous and cuts lock
    contention for auto-follow mode changes.
    [command_server.py, gpio_driver.py]
2026-05-14 TUI: auto-recover from connection drops with recv timeout + resubscribe
    Set 10s socket timeout so readline() doesn't block forever on half-open
    TCP connections from WiFi drops. After 3 consecutive timeouts (30s of
    silence), treat the connection as dead and trigger auto-reconnect.
    Auto-reconnect now calls subscribe() after re-establishing the TCP
    socket so the sensor data stream resumes automatically. Previously it
    reconnected but never re-subscribed, leaving the TUI in a silent
    "connected" state with no data.
    Enable TCP keepalive (5s on macOS) for faster OS-level dead peer
    detection.
2026-05-14 add missing keybindings to left panel, add O to offload recordings
    Left panel now shows auto-follow (F/T/,/./;/'), network (P/r/A/C),
    and offload (O) keybindings that were previously undiscoverable.
    New offload action (O): SCPs all pi_*.csv recordings from the Pi to
    ~/SwitchingCircuitV2_logs/, verifies each file copied successfully,
    then deletes the remote copy. Runs as a background worker so the
    TUI stays responsive.
    [left_panel.py]
2026-05-14 INA226 two-point current calibration with flash persistence
    Firmware: per-channel gain/offset stored in RP2040 flash (last 4KB
    sector). shunt_raw_to_amps() applies calibration inline. New serial
    commands: W (write cal) and U (query cal). Calibration loads on boot
    and survives power cycles. Bounds-checked (gain 0.5-2.0, offset
    +/-100mA).
    Server: relay set/get/reset_calibration commands through gpio_driver
    to the RP2040.
    TUI: calibration wizard (B key) walks through terminal pair selection,
    two reference current entries with live 50-sample averaging, computes
    independent gain/offset per channel, and saves to firmware flash.
    Left panel: removed MODE and SEQUENCE sections (shown in right pane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
    [calibration_screen.py, cmd_parser.c, command_server.py, config.h, gpio_driver.py, ina226.c]
2026-05-14 add fixed plot range: 2-4.5V and ±500mA default, R toggles auto
    Plots default to fixed voltage (2-4.5V) and current (-500mA to 500mA)
    range instead of auto-scaling, which reduces visual noise from small
    fluctuations. Press R to toggle between fixed and auto range.
    The fixed_range parameter threads through _calc_range, _build_braille_plot,
    and _build_bar_plot in both compact and expanded renderers.
    [left_panel.py, sensor_plot.py]
2026-05-14 fix Python 3.9 compat: use Optional[tuple] instead of tuple | None
    [sensor_plot.py]
2026-05-15 fix calibration wizard: arrow keys + enter for pair selection
    Arrow up/down moves the cursor between pairs and Reset All. Enter
    confirms the highlighted selection. Number keys 1-5 still work as
    direct shortcuts.
    [calibration_screen.py]
2026-05-15 TUI: auto-add ethernet subnet route on connect
    After connecting to a Pi, try to add a route to 10.42.1.0/24 via
    that Pi so the Mac can reach other Pis on the ethernet switch.
    Uses sudo -n (non-interactive) so it silently fails if passwordless
    sudo isn't configured for route commands.
2026-05-15 fleet discovery: probe ethernet subnet alongside mDNS
    Pis on the ethernet switch (10.42.1.x) aren't reachable via mDNS
    when the Mac connects through WiFi (different broadcast domain).
    Now discover_fleet also probes 10.42.1.10-254 with TCP connects to
    port 5555, finding ethernet-only Pis. Reverse DNS maps IPs back to
    hostnames for display.
2026-05-15 simplify networking: each Pi runs own AP, TUI switches WiFi
    Revert ap_fallback to unconditional AP mode (oneshot). Remove fleet
    watchdog, client joining, and failover logic — each Pi just broadcasts
    its own pi_SW# AP on boot.
    Rewrite pi_picker to scan for pi_SW# WiFi SSIDs instead of mDNS
    probing. On selection, the picker switches the Mac's WiFi to the
    chosen AP via networksetup/CoreWLAN, verifies the server at 10.42.0.1
    is reachable, then the app reconnects. Direct 1:1 WiFi link per Pi
    with no routing or congestion.
    Fix AP password (raspberry, not switching). Remove ethernet subnet
    routing and discovery code.
    [ap_fallback.py, pi_picker.py]
2026-05-16 latency & connection robustness overhaul
    TUI: TCP_NODELAY eliminates Nagle buffering (up to 40ms per command),
    async send queue so UI thread never blocks on sendall, backpressure
    flag prevents unbounded Textual message queue growth, socket timeout
    reduced to 3s×2 for faster dead-connection detection (6s vs 30s).
    Telemetry: latency probe now tracks Hz, inter-frame jitter, and frame
    drops via bcast_seq gaps — always active, display toggled with D key.
    Server: broadcast sendall timeout tightened to 200ms, bcast_seq counter
    added to payload, RestartSec reduced to 1s.
    Firmware: streaming timer anchored to scheduled cadence (+=period) instead
    of wall time (=now) to eliminate cumulative drift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
    [command_server.py, streaming.c]
2026-05-16 auto-follow: eliminate dead-time open circuit, add CC setpoint recommendations
    The 2ms all-off dead time during mode transitions was breaking external
    cyclers — a CC source driving into a momentarily open circuit spikes
    voltage and trips protection. Now skip dead time for transitions between
    discharge (transparent) and switching modes, since narrowing or widening
    the set of conducting paths has no shoot-through risk.
    Also skip dead time for the reverse (switching → transparent) — going
    from 2 active paths to 4 is just adding parallel conductors.
    Added CC setpoint field to auto-follow: user sets the expected CC
    current (< / > keys), and the panel shows recommended enter/exit
    threshold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
    [auto_follow.py, command_server.py, config.py, left_panel.py, mode_controller.py, right_panel.py]
2026-05-18 TUI: show Pi name (SW1, SW2, etc.) instead of IP in connection bar
    Derives the name from the WiFi SSID (pi_SW4 → SW4) either from the
    Pi picker selection or by detecting current_ssid() on initial connect.
    Connection status now reads "Connected — SW4" / "Connecting to SW4...".
2026-05-20 fix recording done worker storm that froze TUI keyboard input
    After a recording finished, _on_recording_done() was called on every
    state frame (~15Hz) until _data_logger.stop() completed. Each call
    spawned an exclusive worker that cancelled the previous one, but the
    executor threads kept running. For Pi-tier recordings with SSH/SCP
    teardown (up to 28s), this spawned hundreds of concurrent subprocesses,
    exhausting file descriptors and freezing keyboard input.
    Fix: guard flag _stop_in_progress prevents re-entry. Set immediately
    on first call, cleared in the worker's finally block.
    Also: V3 PCB changelist updated with B0512D decoupling requirements
    from SW1 gate drive supply failure.
    Co-Auth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
2026-05-20 fix recording freeze: guard re-entry, isolate worker groups, persist duration
    Three fixes for TUI becoming unresponsive after recording:
    1. Skip recording block in _apply_state when stop is in progress —
    prevents re-entering _on_recording_done() every frame while the
    stop worker is running.
    2. Isolate workers into distinct groups (connect/recording/offload) so
    exclusive=True doesn't cancel unrelated workers across groups.
    3. Make data_logger.stop() robust with try/finally — state flags
    (_tier, _pi_recording, _mac_active) are always cleared even if
    SSH/SCP fails. Errors are logged instead of silently swallowed.
    Also: recording duration now persists to ~/.switching-circu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
2026-05-20 fix auto-follow: eliminate all-off gap during seamless transitions
    engine.pause() sends H (halt) to the RP2040 which turns ALL FETs off
    before the skip_dead check could prevent it. This caused a brief open
    circuit every time auto-follow engaged or disengaged switching.
    Fix: seamless transitions now bypass pause() entirely.
    DISCHARGE → CHARGE/PULSE_CHARGE: resume() sends C+F+G directly;
    the G command immediately applies the first switching state. FETs go
    from all-on to the switching pattern with no gap.
    CHARGE/PULSE_CHARGE → DISCHARGE: all_on() sets FETs first (seamless),
    then stop_switching() halts the timer, then pause_silent() marks the
    engine paused without sending H. No all-off in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
    [mode_controller.py, sequence_engine.py]
2026-05-20 fix seamless CHARGE→DISCHARGE: reprogram cycle instead of H command
    stop_switching() sends H which turns all FETs off — using it in the
    seamless path defeated the entire purpose. Now reprogram the cycle to
    a single all-on state (C 1 15) so the firmware timer applies all-on
    on every tick, then immediately set all-on via S. No FET state gap.
    The timer keeps running harmlessly applying all-on; resume() will
    reprogram it with the real switching pattern when auto-follow re-engages.
    [mode_controller.py]
2026-05-20 auto-follow: 2s hold-off timer prevents single-frame oscillation
    After entering switching mode, exit checks are suppressed for 2 seconds
    so the cycler can stabilize. Without this, the 15Hz poll could catch a
    switching half-cycle where only one path is active, see reduced current,
    and immediately trip the exit threshold — causing a single-frame
    engage/disengage bounce.
    [auto_follow.py]
2026-05-20 firmware + server: seamless FET transitions via live commands E and Y
    Root cause: every C command called switching_halt() which turned all
    FETs off. Every S command also halted if the timer was running. There
    was no way to do seamless auto-follow transitions from the Pi side.
    Firmware changes:
    - switching_program_cycle_live(): swaps cycle buffer under interrupt
    disable without halting timer or touching FETs
    - switching_set_direct_no_halt(): sets FET pins without stopping timer
    - E command: live cycle reprogram (same syntax as C, no halt)
    - Y command: set FETs without halt (same syntax as S, no halt)
    Server changes:
    - gpio_driver: program_sequence_live() (E), all_on_no_halt() (Y)
    - sequen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
    [cmd_parser.c, gpio_driver.py, mode_controller.py, sequence_engine.py, switching.c, switching.h]
2026-05-20 fix 71-minute timestamp wrap: emit 64-bit ticks_us from firmware
    fw_ticks_us was truncated to uint32 (wraps at ~71.6 min), causing
    elapsed_s to go negative and breaking step detection. Now all three
    timestamp emission points (D lines, P clock sync, G anchor) use the
    full uint64 from time_us_64(). Python's int() handles 64-bit natively.
    Also raised MAX_FREQ from 300 to 1000 Hz in the TUI.
    [cmd_parser.c, streaming.c, switching.c, switching.h]
2026-05-21 fix 1-2s sample gap at switching transitions
    Two causes: (1) _program_and_go_live sent 4 blocking serial round-trips
    (E+F+P+G), each waiting up to 0.5s for a response buried behind D-lines
    in the reader thread queue. At high sample rates the OK responses were
    delayed, causing timeouts and a 1-2s command storm. Fix: skip
    sync_firmware_clock() in the live path (3 commands instead of 4, clock
    offset from initial connect is sufficient for auto-follow).
    (2) The streaming timer snap-forward guard (added for drift fix) skipped
    all samples when the main loop was blocked >2 periods. Reverted to
    s_last_emit_us = now (one sample per main-loop pass, resume from current
    time after any gap). The host det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
    [sequence_engine.py, streaming.c]
2026-05-23 V3: locked BOM with verified LCSC stock, updated spec to match
    BOM changes from review:
    - ADC: 2× ADS131M04 (C5121509, 3.5K stock) replaces 1× ADS131M08
    - MOSFETs: AO3400A SOT-23 retained from V2, max current capped at 3A
    - Shunts: TA-I RLP25FEGR010 (C393070, 77K stock)
    - Voltage divider: 91kΩ/9.1kΩ (10.01:1, calibrated in firmware)
    - Cycler input: 4× Kelvin clip pads (22×8mm, ENIG) replace screw terminal
    - Cell output: split into 2× 2-pos screw terminals (J2a pos, J2b neg)
    - Optional 5V buck converter footprint (DNP, solder jumper selectable)
    - All passives switched to verified in-stock YAGEO/Murata/Samsung parts
    - Every LCSC part number linked and stock-verified as of 2026-05-23
    Sp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
2026-05-23 V3: datasheet audit fixes + reusable agent definitions
    Ran 4-agent parallel datasheet audit against all V3 BOM components.
    Cross-referenced every electrical/thermal claim against extracted
    datasheet text. 63 PASS, 11 FAIL, 2 UNVERIFIABLE.
    Key fixes:
    - AO3400A: R_DS(on) max 26.5mΩ not 20mΩ, θ_JA 125°C/W not 312°C/W,
    I_D 5.7A not 5.8A, recalculated thermal (ΔT≈30°C, design is safer)
    - ADS131M04: DVDD is external supply not LDO output, IOVDD pin doesn't
    exist (removed), added missing 220nF CAP pin cap, upgraded C_DVDD
    to 1µF per datasheet
    - UCC5304 VDD bulk caps: all four now 1206 50V (12V across VDD-VSS)
    - B0512S-1WR3: added 1.5kΩ bleeder resistors (min load 9mA vs ~2.5mA
    U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
2026-05-23 fix new part numbers: C_CAP was 22pF not 220nF, correct specs
    - C_CAP: C1653 (22pF) → C21120 (220nF X7R 25V, Samsung, 1.2M stock)
    - C_DVDD: corrected description to X5R 50V (actual C15849 specs)
    - Bleeder resistor: corrected manufacturer to UNI-ROYAL (not YAGEO)
    - All new LCSC parts verified in-stock via product pages
2026-05-24 V3: datasheet audit fixes, NeoPixel level shift, correct Mornsun datasheet
    Five-agent audit checked 92 BOM/spec claims against datasheets. Fixes:
    - Voltage divider ratio: 10.01:1 → 11.0:1 (prose was wrong, code was correct)
    - ADC decoupling caps C_DVDD/C_CAP/C_VREF: qty 1 → 2 (one per device)
    - Passive summary: 100nF count 20→26, 10µF 1206 count 1→5
    - UCC5304 VDD cap: spec said 0805, corrected to 1206 50V (matches BOM)
    - B0512S hand-solder qty: 2→3, summary table updated
    - Bleeder resistor: 0603→0805 for thermal margin (96mW vs 125mW rating)
    - Gate LED labels: "FET commanded" → "FET idle" (LEDs on when gate LOW)
    - Ring buffer 78KB→64KB, recording duration 56→58 hrs
    - 3.3V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
2026-05-24 V3: datasheet audit fixes — 13 corrections from 167-claim re-audit
    Design decisions: remove C_VREF (M04 has no REFP/REFN pins), bleeder
    1.5kΩ→1.2kΩ (fixes value/LCSC mismatch, adds min-load margin),
    C_AVDD2 per-device qty 2, PS3 decoupling resolved via UCC5304 VDD caps.
    Doc fixes: bus voltage LSB 10× error (15.7→1.57 µV/bit), ADS current
    32→9 mA, 5V budget efficiency 89→83%, frame length 34→33, ring buffer
    32→33 bytes, cap load includes VDD caps, 1N4148W Vf from datasheet
    (0.855V max @10mA, not 0.65V) with firmware brightness constraint.
2026-05-25 V3: schematic complete — 134-part KiCad 10 project with verified symbols
    Repo restructure:
    - GitHub renamed to Switch_Charging (remote updated)
    - pcb/ split into v2/ (existing V2 board) and v3/ (new V3 project)
    V3 schematic (pcb/v3/):
    - gen_schematic_v3.py generates 134-part flat schematic from Python DSL
    - Custom KiCad symbols: Pico2, ADS131M04, INA180A1 (+ carried UCC5304, B0512S)
    - Custom footprints: Pico2_SocketedTH (2x20 TH), TF_PUSH (microSD)
    - SCHEMATIC_SPEC.md: pin-level source of truth for every part/net
    Critical design fixes found and applied:
    - High-side shunt CM voltage (up to 10V) exceeds ADS131M04 abs max (3.6V)
    → Added 2x INA180A1 current-sense amplifiers (gain=20, CM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
    [Switching_Circuit_BOM.csv, bom.csv, bom_jlc.csv, positions_jlc.csv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]
2026-05-25 remove KiCad temp files from tracking, update .gitignore
2026-05-26 V3: add placement guide, update KiCad layout and schematic
    Add pcb/v3/PLACEMENT_GUIDE.md with checkboxed component placement map
    organized by functional block (protection, power stage, gate drivers,
    analog front-end, MCU, peripherals) for KiCad layout reference.
    [switching_circuit_v3.kicad_pcb, switching_circuit_v3.kicad_sch]
2026-05-26 fix V2 hardware corrections: INA226 address, alert pin, B0512S polarity
    - Move ALERT pin from GP27 to GP29 to match V2 board routing
    - Fix N1 INA226 address from 0x43 to 0x49
    - Correct B0512S-1WR3 pin assignments (Vin+/- and Vout+/- were swapped)
    - Add V2 changelist, connection graph, and component specs
    [main.py]
2026-05-29 fleet: add Windows netsh support to wifi_scan (scan + AP join)
    wifi_scan only implemented scan/join for macOS and Linux; on Windows
    scan returned empty and join returned 'unsupported platform', so the
    fleet AP cycler could not drive a Windows WiFi adapter at all.
    Add a netsh-based Windows path:
    - scan via 'netsh wlan show networks mode=bssid', strongest BSSID per
    pi_SW# SSID, signal percent -> approx dBm
    - current SSID + wireless interface detection via 'netsh wlan show
    interfaces'
    - join by synthesizing a PSK profile XML, 'netsh wlan add profile' +
    'netsh wlan connect'
    Two field-discovered fixes baked in:
    - the Pi APs advertise WPA-Personal (NM key-mgmt=wpa-psk, no proto), so
    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
2026-05-31 fleet dashboard: fix sequence indexing, grey out inapplicable fields, fix AF command keys
    Sequence was off by one in both directions. The Pi/TUI/server convention
    is a 0-based index on the wire (0-7) shown as index+1 to humans; the
    dashboard treated the value as 1-based:
    - read: seqLabel did SEQUENCES[seq-1] -> now SEQUENCES[seq], so e.g. an
    all-on Pi (index 7) reads '8: all-on' instead of '7'.
    - write: edit/batch selectors sent i+1 -> now send the 0-based index i,
    and the edit dropdown defaults to the Pi's current sequence.
    Auto-follow command key mismatches (silently rejected by the server):
    - auto_follow_set_target sent 'target' -> server reads 'target_mode'
    - auto_follow_set_cc_setp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
